trlafleur/Sensor-3/README.md

# Sensor-3-4

Sensor 3, Water Presssure, Moisture and flow sensor. Uses a Feather or RocketStream processor

Sensor 4, has an embedded M4F CPU, RFM95CW and CubeCell AM01 LoRa radio

Sensor 4a, Has an embedded M0 CPU, RFM95CW and E78-900M22S LoRa radio

See .PDF for documentation
