trlafleur/Sensor-3/WaterSensor V3-5b.xls

Sheet: Part List Report
Part List |  | Bill of Materials for PCB Document [PCB1.PcbDoc]
Source Data From: |  | PCB1.PcbDoc
Project: |  | WaterSensor V3-5b.PrjPcb
Variant: |  | None
Report Date: | 10/23/2019 | 3:49 PM
Print Date: | 2019-10-23 | 15:49:48
Designator | Comment | LibRef | Footprint | Description
C1, C10 | TBD | CAP_1 | 805 | Capacitor
C2, C21 | .1uf | CAP_1, CAP_2 | 6-0805 | Capacitor
C3, C23 | 47uf | CAP_1 | C1210 | Capacitor
C4 | Cap Pol2 | Cap Pol2 | Capacitor 12x5x18 | Polarized Capacitor (Axial)
C5, C11, C12, C13, C14, C19 | .1uf | CAP_1 | 805 | Capacitor
C6, C7, C9 | 22uf | CAP_1 | C1206 | Capacitor
C8 | 10uf/50V | CAP_1 | C1206 | Capacitor
C17 | 10uf | CAP_1 | C1206 | Capacitor
C20 | .22uf | CAP_1 | 6-0805 | Capacitor
C22 | 22uf | CAP_2 | 805 | Capacitor
C24 | .022uf | CAP_1 | 805 | Capacitor
D1 | DF01S | Bridge DF01S | SOP4-BRIDGE
D2 | Charge | LTST150 | LED 0805
D4 | Error | LTST150 | LED 0805
D5 | RX | LTST150 | LED 0805
D6 | TX | LTST150 | LED 0805
D7 | PWR 3.3V | LTST150 | LED 0805
D8, D9, D10, D11 | MMBZxV1A | MMBZ9V1A | SOT23 | Zener Transient Voltage Suppressors
D12, D15, D16 | MBR140SFT1G | Diode Schottky | SOD123FL-2 | Schottky Diode
F1 | Poly Fuse 300ma | Poly Fuse | PTC 2016L | Poly Fuse
F2 | Poly Fuse 50ma | Poly Fuse | c1206 | Poly Fuse
J1 | TS2A | TS2A | TS3.81X2 | Screw Terminal, 3.81mm (.15in) 2X
J2, J3 | TS8A | TS8A | TS3.81X8 | Screw Terminal 3.81mm (.15in) 8X
L1 | SRR5028-470Y | SRR5028-470Y | BOUR-SRR5028_V -MOD | SDR0403 Series Power Inductor, 18 uF +/- 20 %, 0.34 Ohm, -40 to 125 degC, 2-Pin SMD, RoHS, Tape and Reel
P1 | Extra | Header 6 | HDR1X6 | Header, 6-Pin
P2 | UART1-FTDI-3.3V | Header 6 | HDR1X6 | Header, 6-Pin
P3 | I2C | Header 4 | HDR1X4 | Header, 4-Pin
R1, R2, R18 | TBD | ERJ8EN | 6-0805 | Precision Thick Film Chip Resistor, 10 Ohm to 2.2M Ohm Range, 1% Tolerance, 1206 Size, 0.125 W
R3, R23, R32 | 10K | ERJ8EN | 6-0805 | Precision Thick Film Chip Resistor, 10 Ohm to 2.2M Ohm Range, 1% Tolerance, 1206 Size, 0.125 W
R4 | 560 | ERJ8EN | 6-0805 | Precision Thick Film Chip Resistor, 10 Ohm to 2.2M Ohm Range, 1% Tolerance, 1206 Size, 0.125 W
R5, R6, R7, R8 | 1k | ERJ8EN | 6-0805 | Precision Thick Film Chip Resistor, 10 Ohm to 2.2M Ohm Range, 1% Tolerance, 1206 Size, 0.125 W
R9, R10 | 4.7k | ERJ8EN | 6-0805 | Precision Thick Film Chip Resistor, 10 Ohm to 2.2M Ohm Range, 1% Tolerance, 1206 Size, 0.125 W
R11, R12 | 4.7k 1% | ERJ8EN | 6-0805 | Precision Thick Film Chip Resistor, 10 Ohm to 2.2M Ohm Range, 1% Tolerance, 1206 Size, 0.125 W
R13, R20, R21, R24, R28, R29 | 0 Ohms | ERJ8EN | 6-0805 | Precision Thick Film Chip Resistor, 10 Ohm to 2.2M Ohm Range, 1% Tolerance, 1206 Size, 0.125 W
R17 | TBD | ERJ8EN | C1206 | Precision Thick Film Chip Resistor, 10 Ohm to 2.2M Ohm Range, 1% Tolerance, 1206 Size, 0.125 W
R19, R22, R30 | NU | ERJ8EN | 6-0805 | Precision Thick Film Chip Resistor, 10 Ohm to 2.2M Ohm Range, 1% Tolerance, 1206 Size, 0.125 W
R26 | 5.76k 1% | ERJ8EN | 6-0805 | Precision Thick Film Chip Resistor, 10 Ohm to 2.2M Ohm Range, 1% Tolerance, 1206 Size, 0.125 W
R27 | 1.02k 1% | ERJ8EN | 6-0805 | Precision Thick Film Chip Resistor, 10 Ohm to 2.2M Ohm Range, 1% Tolerance, 1206 Size, 0.125 W
R31 | 56k | ERJ8EN | 6-0805 | Precision Thick Film Chip Resistor, 10 Ohm to 2.2M Ohm Range, 1% Tolerance, 1206 Size, 0.125 W
R33 | 5.1k | ERJ8EN | 6-0805 | Precision Thick Film Chip Resistor, 10 Ohm to 2.2M Ohm Range, 1% Tolerance, 1206 Size, 0.125 W
R34 | 51k | ERJ8EN | 6-0805 | Precision Thick Film Chip Resistor, 10 Ohm to 2.2M Ohm Range, 1% Tolerance, 1206 Size, 0.125 W
R37, R38 | 0 | ERJ8EN | 6-0805 | Precision Thick Film Chip Resistor, 10 Ohm to 2.2M Ohm Range, 1% Tolerance, 1206 Size, 0.125 W
U1 | LM2842-Q1 SOT23-6 | LM2842 | sot23-6 | .6A SIMPLE SWITCHER® Step-Down Voltage Regulator SOT23-6
U2 | MCP73831-x | MCP7381 | SOT-23-OT5_L | MCP73831 Li-Ion, Li-Polymer Charger
U3 | Adafruit Feather M0 LoRa | Feather M0 LoRa | Feather-DIP28-800mil - duplicate | Feather M0 LoRa
U4 | MAX6816 | MAX6816 | SOT143-4 | Max6816 Switch Debounce, CMOS
U5 | MCP9800A1T | MCP9800A1T | SOT-23-OT5_L | Temperature Sensor, I2C
U6 | 74HC4052 | 74HC4052 | SOP127P1030X265-16L | Dual 4-channel aAalog Mux
U7 | Si7021 | Si7021 | QFN3x3-6pin | Humidity & Temperature Sensor, I2C, 3x3mm
U8 | 74LVC2G14 | 74LVC2G07 | sot23-6 | Dual OC Driver
U9 | Rocketscream M0 LoRa | Rocket M0 LoRa | Rocket-DIP38-900mil | Rocket M0 LoRa
U10 | MIC2015 SOT23-6 | MIC2015-6 | SOT23-6_N | Power Switch, 500ma 6pin
U11 | BME680 | BME680 | BME680-EXT-Pad | Integrated Environmental Unit
U12 | BME280 | CMP-2000-05073-1 | BOSC-BME280-8_V | Combined Humidity and Pressure Sensor, 1.71 to 3.6 V, -40 to 85 degC, 8-Pin SMD, RoHS, Tape and Reel
U13 | FM24CL64B | FM24CL64B | MCHP-SOIC-SN8_N | 2K I2C Serial EEPROMs with EUI-64 Node Identity, 1.7 to 5.5 V, 400 KHz, Industrial Temperature, 8-Pin SOIC (SN8), Tape and Reel
U14 | 24AA025E64 | FM24CL64B | MCHP-SOIC-SN8_N | 2K I2C Serial EEPROMs with EUI-64 Node Identity, 1.7 to 5.5 V, 400 KHz, Industrial Temperature, 8-Pin SOIC (SN8), Tape and Reel
U15 | TC1262-3.3VDBTR | TC1262-3.3VDBTR | SOT-223-DB3_N | 500mA Fixed Output CMOS LDO, 3-Pin SOT-223, Extended Temperature, Tape and Reel
U16 | MCP6001T-E/OT | CMP-0187-00458-2 | SOT-23-OT5_N | 1 MHz, Low-Power Operational Amplifier, 5-Pin SOT-23, Extended Temperature, Tape and Reel
U17 | 1051-RCR123A | 1051 | 1051 | Undefined or Miscellaneous

Sheet: All Data
Designator | Comment | Footprint | #Column Name Error:' Layer | #Column Name Error:' Rotation | #Column Name Error:' Height(Mil) | #Column Name Error:' Height(mm) | #Column Name Error:' Center-X(Mil) | #Column Name Error:' Center-X(mm) | #Column Name Error:' Center-Y(Mil) | #Column Name Error:' Center-Y(mm) | #Column Name Error:' Pad-X(Mil) | #Column Name Error:' Pad-X(mm) | #Column Name Error:' Pad-Y(Mil) | #Column Name Error:' Pad-Y(mm) | #Column Name Error:' Ref-X(Mil) | #Column Name Error:' Ref-X(mm) | #Column Name Error:' Ref-Y(Mil) | #Column Name Error:' Ref-Y(mm)
C1, C10 | TBD | 805
C2, C21 | .1uf | 6-0805
C3, C23 | 47uf | C1210
C4 | Cap Pol2 | Capacitor 12x5x18
C5, C11, C12, C13, C14, C19 | .1uf | 805
C6, C7, C9 | 22uf | C1206
C8 | 10uf/50V | C1206
C17 | 10uf | C1206
C20 | .22uf | 6-0805
C22 | 22uf | 805
C24 | .022uf | 805
D1 | DF01S | SOP4-BRIDGE
D2 | Charge | LED 0805
D4 | Error | LED 0805
D5 | RX | LED 0805
D6 | TX | LED 0805
D7 | PWR 3.3V | LED 0805
D8, D9, D10, D11 | MMBZxV1A | SOT23
D12, D15, D16 | MBR140SFT1G | SOD123FL-2
F1 | Poly Fuse 300ma | PTC 2016L
F2 | Poly Fuse 50ma | c1206
J1 | TS2A | TS3.81X2
J2, J3 | TS8A | TS3.81X8
L1 | SRR5028-470Y | BOUR-SRR5028_V -MOD
P1 | Extra | HDR1X6
P2 | UART1-FTDI-3.3V | HDR1X6
P3 | I2C | HDR1X4
R1, R2, R18 | TBD | 6-0805
R3, R23, R32 | 10K | 6-0805
R4 | 560 | 6-0805
R5, R6, R7, R8 | 1k | 6-0805
R9, R10 | 4.7k | 6-0805
R11, R12 | 4.7k 1% | 6-0805
R13, R20, R21, R24, R28, R29 | 0 Ohms | 6-0805
R17 | TBD | C1206
R19, R22, R30 | NU | 6-0805
R26 | 5.76k 1% | 6-0805
R27 | 1.02k 1% | 6-0805
R31 | 56k | 6-0805
R33 | 5.1k | 6-0805
R34 | 51k | 6-0805
R37, R38 | 0 | 6-0805
U1 | LM2842-Q1 SOT23-6 | sot23-6
U2 | MCP73831-x | SOT-23-OT5_L
U3 | Adafruit Feather M0 LoRa | Feather-DIP28-800mil - duplicate
U4 | MAX6816 | SOT143-4
U5 | MCP9800A1T | SOT-23-OT5_L
U6 | 74HC4052 | SOP127P1030X265-16L
U7 | Si7021 | QFN3x3-6pin
U8 | 74LVC2G14 | sot23-6
U9 | Rocketscream M0 LoRa | Rocket-DIP38-900mil
U10 | MIC2015 SOT23-6 | SOT23-6_N
U11 | BME680 | BME680-EXT-Pad
U12 | BME280 | BOSC-BME280-8_V
U13 | FM24CL64B | MCHP-SOIC-SN8_N
U14 | 24AA025E64 | MCHP-SOIC-SN8_N
U15 | TC1262-3.3VDBTR | SOT-223-DB3_N
U16 | MCP6001T-E/OT | SOT-23-OT5_N
U17 | 1051-RCR123A | 1051

Sheet: Metric
Designator | Comment | Footprint | #Column Name Error:' Layer | #Column Name Error:' Rotation | #Column Name Error:' Center-X(mm) | #Column Name Error:' Center-Y(mm) | #Column Name Error:' Pad-X(mm) | #Column Name Error:' Pad-Y(mm) | #Column Name Error:' Ref-X(mm) | #Column Name Error:' Ref-Y(mm)
C1, C10 | TBD | 805
C2, C21 | .1uf | 6-0805
C3, C23 | 47uf | C1210
C4 | Cap Pol2 | Capacitor 12x5x18
C5, C11, C12, C13, C14, C19 | .1uf | 805
C6, C7, C9 | 22uf | C1206
C8 | 10uf/50V | C1206
C17 | 10uf | C1206
C20 | .22uf | 6-0805
C22 | 22uf | 805
C24 | .022uf | 805
D1 | DF01S | SOP4-BRIDGE
D2 | Charge | LED 0805
D4 | Error | LED 0805
D5 | RX | LED 0805
D6 | TX | LED 0805
D7 | PWR 3.3V | LED 0805
D8, D9, D10, D11 | MMBZxV1A | SOT23
D12, D15, D16 | MBR140SFT1G | SOD123FL-2
F1 | Poly Fuse 300ma | PTC 2016L
F2 | Poly Fuse 50ma | c1206
J1 | TS2A | TS3.81X2
J2, J3 | TS8A | TS3.81X8
L1 | SRR5028-470Y | BOUR-SRR5028_V -MOD
P1 | Extra | HDR1X6
P2 | UART1-FTDI-3.3V | HDR1X6
P3 | I2C | HDR1X4
R1, R2, R18 | TBD | 6-0805
R3, R23, R32 | 10K | 6-0805
R4 | 560 | 6-0805
R5, R6, R7, R8 | 1k | 6-0805
R9, R10 | 4.7k | 6-0805
R11, R12 | 4.7k 1% | 6-0805
R13, R20, R21, R24, R28, R29 | 0 Ohms | 6-0805
R17 | TBD | C1206
R19, R22, R30 | NU | 6-0805
R26 | 5.76k 1% | 6-0805
R27 | 1.02k 1% | 6-0805
R31 | 56k | 6-0805
R33 | 5.1k | 6-0805
R34 | 51k | 6-0805
R37, R38 | 0 | 6-0805
U1 | LM2842-Q1 SOT23-6 | sot23-6
U2 | MCP73831-x | SOT-23-OT5_L
U3 | Adafruit Feather M0 LoRa | Feather-DIP28-800mil - duplicate
U4 | MAX6816 | SOT143-4
U5 | MCP9800A1T | SOT-23-OT5_L
U6 | 74HC4052 | SOP127P1030X265-16L
U7 | Si7021 | QFN3x3-6pin
U8 | 74LVC2G14 | sot23-6
U9 | Rocketscream M0 LoRa | Rocket-DIP38-900mil
U10 | MIC2015 SOT23-6 | SOT23-6_N
U11 | BME680 | BME680-EXT-Pad
U12 | BME280 | BOSC-BME280-8_V
U13 | FM24CL64B | MCHP-SOIC-SN8_N
U14 | 24AA025E64 | MCHP-SOIC-SN8_N
U15 | TC1262-3.3VDBTR | SOT-223-DB3_N
U16 | MCP6001T-E/OT | SOT-23-OT5_N
U17 | 1051-RCR123A | 1051

Sheet: Imperial
Designator | Comment | Footprint | #Column Name Error:' Layer | #Column Name Error:' Rotation | #Column Name Error:' Center-X(Mil) | #Column Name Error:' Center-Y(Mil) | #Column Name Error:' Pad-X(Mil) | #Column Name Error:' Pad-Y(Mil) | #Column Name Error:' Ref-X(Mil) | #Column Name Error:' Ref-Y(Mil)
C1, C10 | TBD | 805
C2, C21 | .1uf | 6-0805
C3, C23 | 47uf | C1210
C4 | Cap Pol2 | Capacitor 12x5x18
C5, C11, C12, C13, C14, C19 | .1uf | 805
C6, C7, C9 | 22uf | C1206
C8 | 10uf/50V | C1206
C17 | 10uf | C1206
C20 | .22uf | 6-0805
C22 | 22uf | 805
C24 | .022uf | 805
D1 | DF01S | SOP4-BRIDGE
D2 | Charge | LED 0805
D4 | Error | LED 0805
D5 | RX | LED 0805
D6 | TX | LED 0805
D7 | PWR 3.3V | LED 0805
D8, D9, D10, D11 | MMBZxV1A | SOT23
D12, D15, D16 | MBR140SFT1G | SOD123FL-2
F1 | Poly Fuse 300ma | PTC 2016L
F2 | Poly Fuse 50ma | c1206
J1 | TS2A | TS3.81X2
J2, J3 | TS8A | TS3.81X8
L1 | SRR5028-470Y | BOUR-SRR5028_V -MOD
P1 | Extra | HDR1X6
P2 | UART1-FTDI-3.3V | HDR1X6
P3 | I2C | HDR1X4
R1, R2, R18 | TBD | 6-0805
R3, R23, R32 | 10K | 6-0805
R4 | 560 | 6-0805
R5, R6, R7, R8 | 1k | 6-0805
R9, R10 | 4.7k | 6-0805
R11, R12 | 4.7k 1% | 6-0805
R13, R20, R21, R24, R28, R29 | 0 Ohms | 6-0805
R17 | TBD | C1206
R19, R22, R30 | NU | 6-0805
R26 | 5.76k 1% | 6-0805
R27 | 1.02k 1% | 6-0805
R31 | 56k | 6-0805
R33 | 5.1k | 6-0805
R34 | 51k | 6-0805
R37, R38 | 0 | 6-0805
U1 | LM2842-Q1 SOT23-6 | sot23-6
U2 | MCP73831-x | SOT-23-OT5_L
U3 | Adafruit Feather M0 LoRa | Feather-DIP28-800mil - duplicate
U4 | MAX6816 | SOT143-4
U5 | MCP9800A1T | SOT-23-OT5_L
U6 | 74HC4052 | SOP127P1030X265-16L
U7 | Si7021 | QFN3x3-6pin
U8 | 74LVC2G14 | sot23-6
U9 | Rocketscream M0 LoRa | Rocket-DIP38-900mil
U10 | MIC2015 SOT23-6 | SOT23-6_N
U11 | BME680 | BME680-EXT-Pad
U12 | BME280 | BOSC-BME280-8_V
U13 | FM24CL64B | MCHP-SOIC-SN8_N
U14 | 24AA025E64 | MCHP-SOIC-SN8_N
U15 | TC1262-3.3VDBTR | SOT-223-DB3_N
U16 | MCP6001T-E/OT | SOT-23-OT5_N
U17 | 1051-RCR123A | 1051

Sheet: Project Information
Project Full Path | C:\Users\lafleur\Desktop\Altium Projects\WaterSensor3 Rev5b LoRa - Feather\WaterSensor V3-5b.PrjPcb
Project Filename | WaterSensor V3-5b.PrjPcb
Variant Name | None
Data-Source Filename | PCB1.PcbDoc
Data-Source Full Path | C:\Users\lafleur\Desktop\Altium Projects\WaterSensor3 Rev5b LoRa - Feather\PCB1.PcbDoc
Title | Bill of Materials for PCB Document [PCB1.PcbDoc]
Total Quantity | 92
Report Time | 3:49 PM
Report Date | 10/23/2019
Report Date & Tine | 10/23/2019 3:49 PM
Output Name | Bill of Materials
Output Type | BOM_PartType
Output Generator Name | BOM
Output Generator Description | Bill of Materials
