trlafleur/Sensor-3/WaterSensor V3-5c.pdf

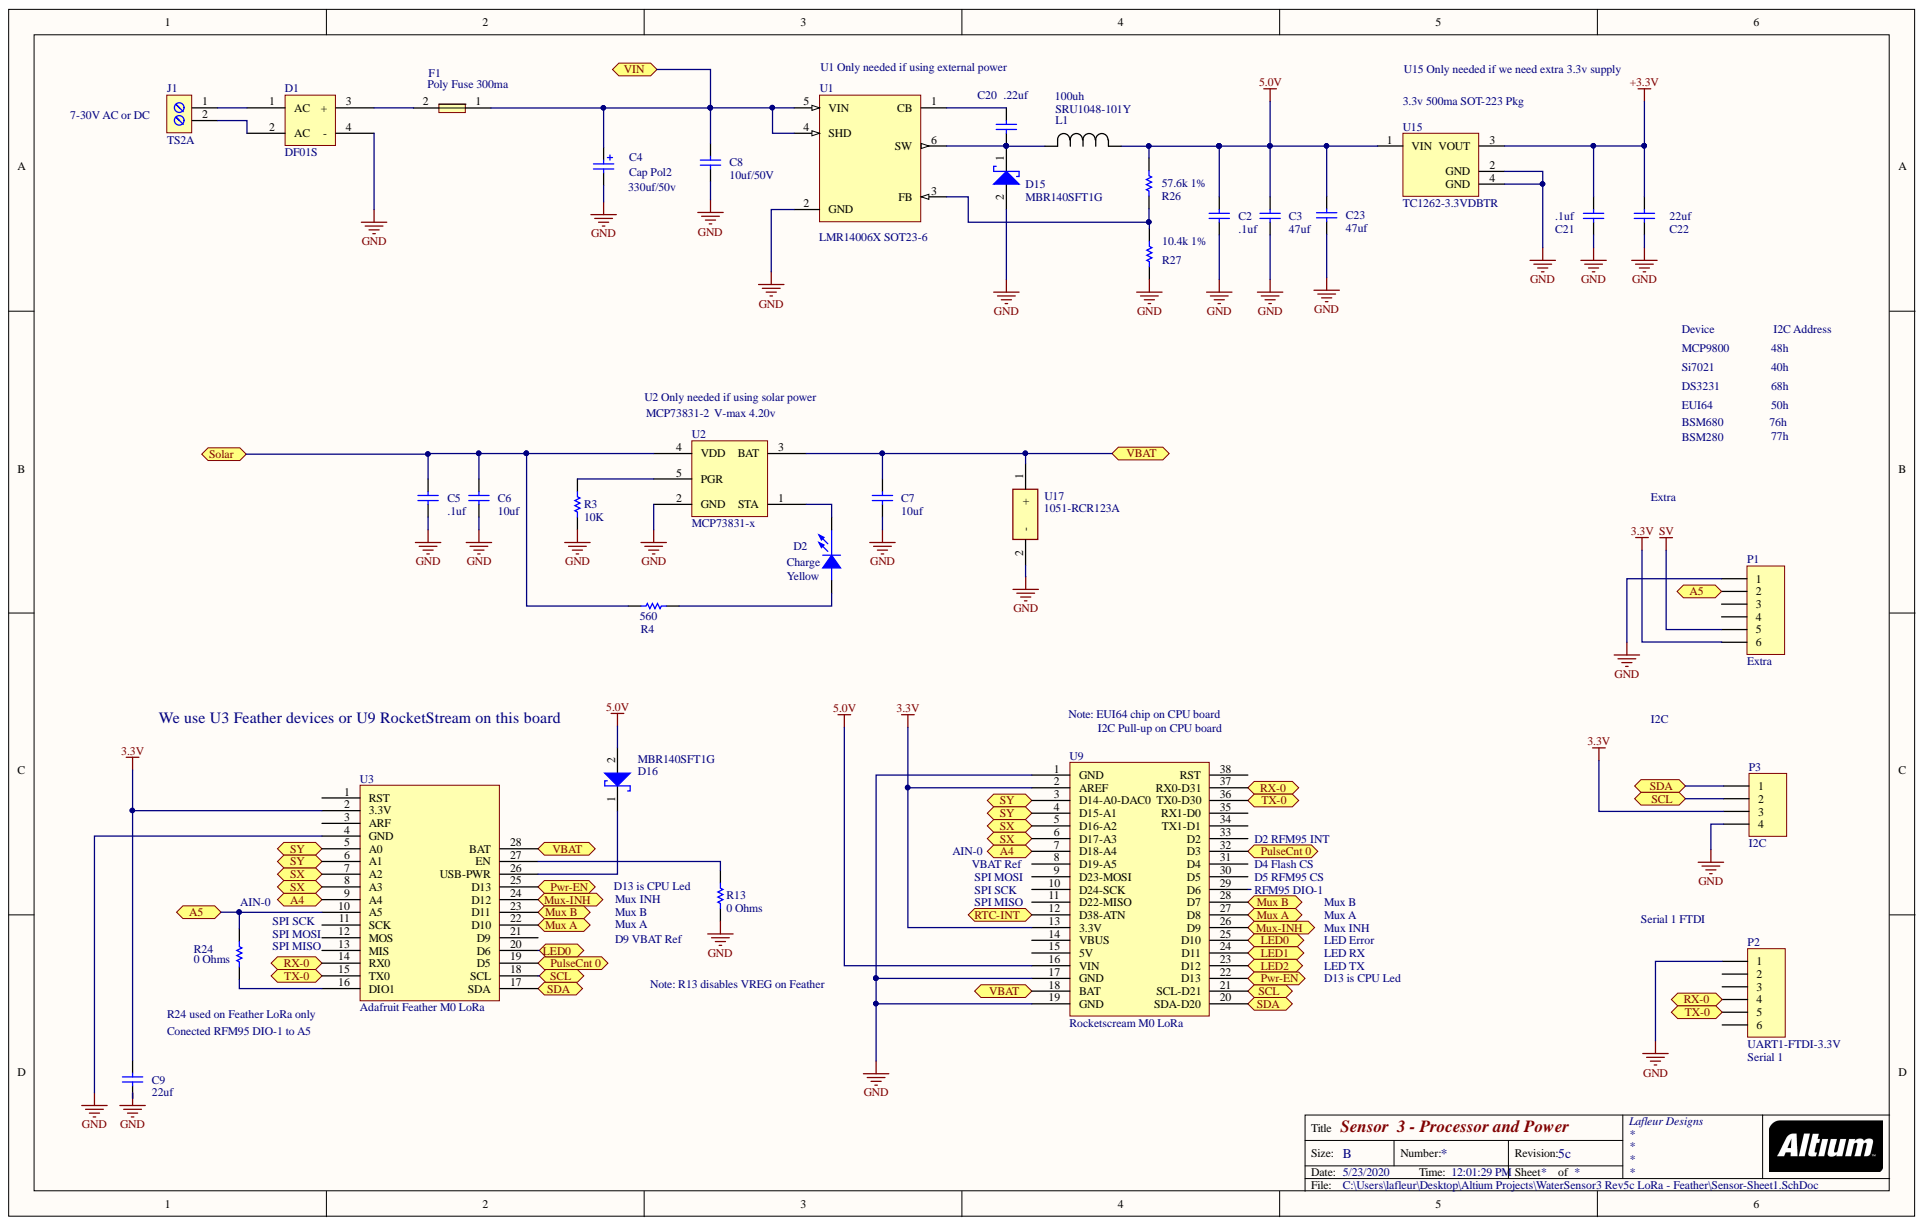
[picture p1: page 1]

U1 Only needed if using external power

U2 Only needed if using solar power
MCP73831-2 V-max 4.20v

I2C Pull-up on CPU board We use U3 Feather devices or U9 RocketStream on this board

Note: EUI64 chip on CPU board

Note: R13 disables VREG on Feather

R24 used on Feather LoRa only
Conected RFM95 DIO-1 to A5

Sensor 3 - Processor and Power
Title

C:\Users\lafleur\Desktop\Altium Projects\WaterSensor3 Rev5c LoRa - Feather\Sensor-Sheet1.SchDoc

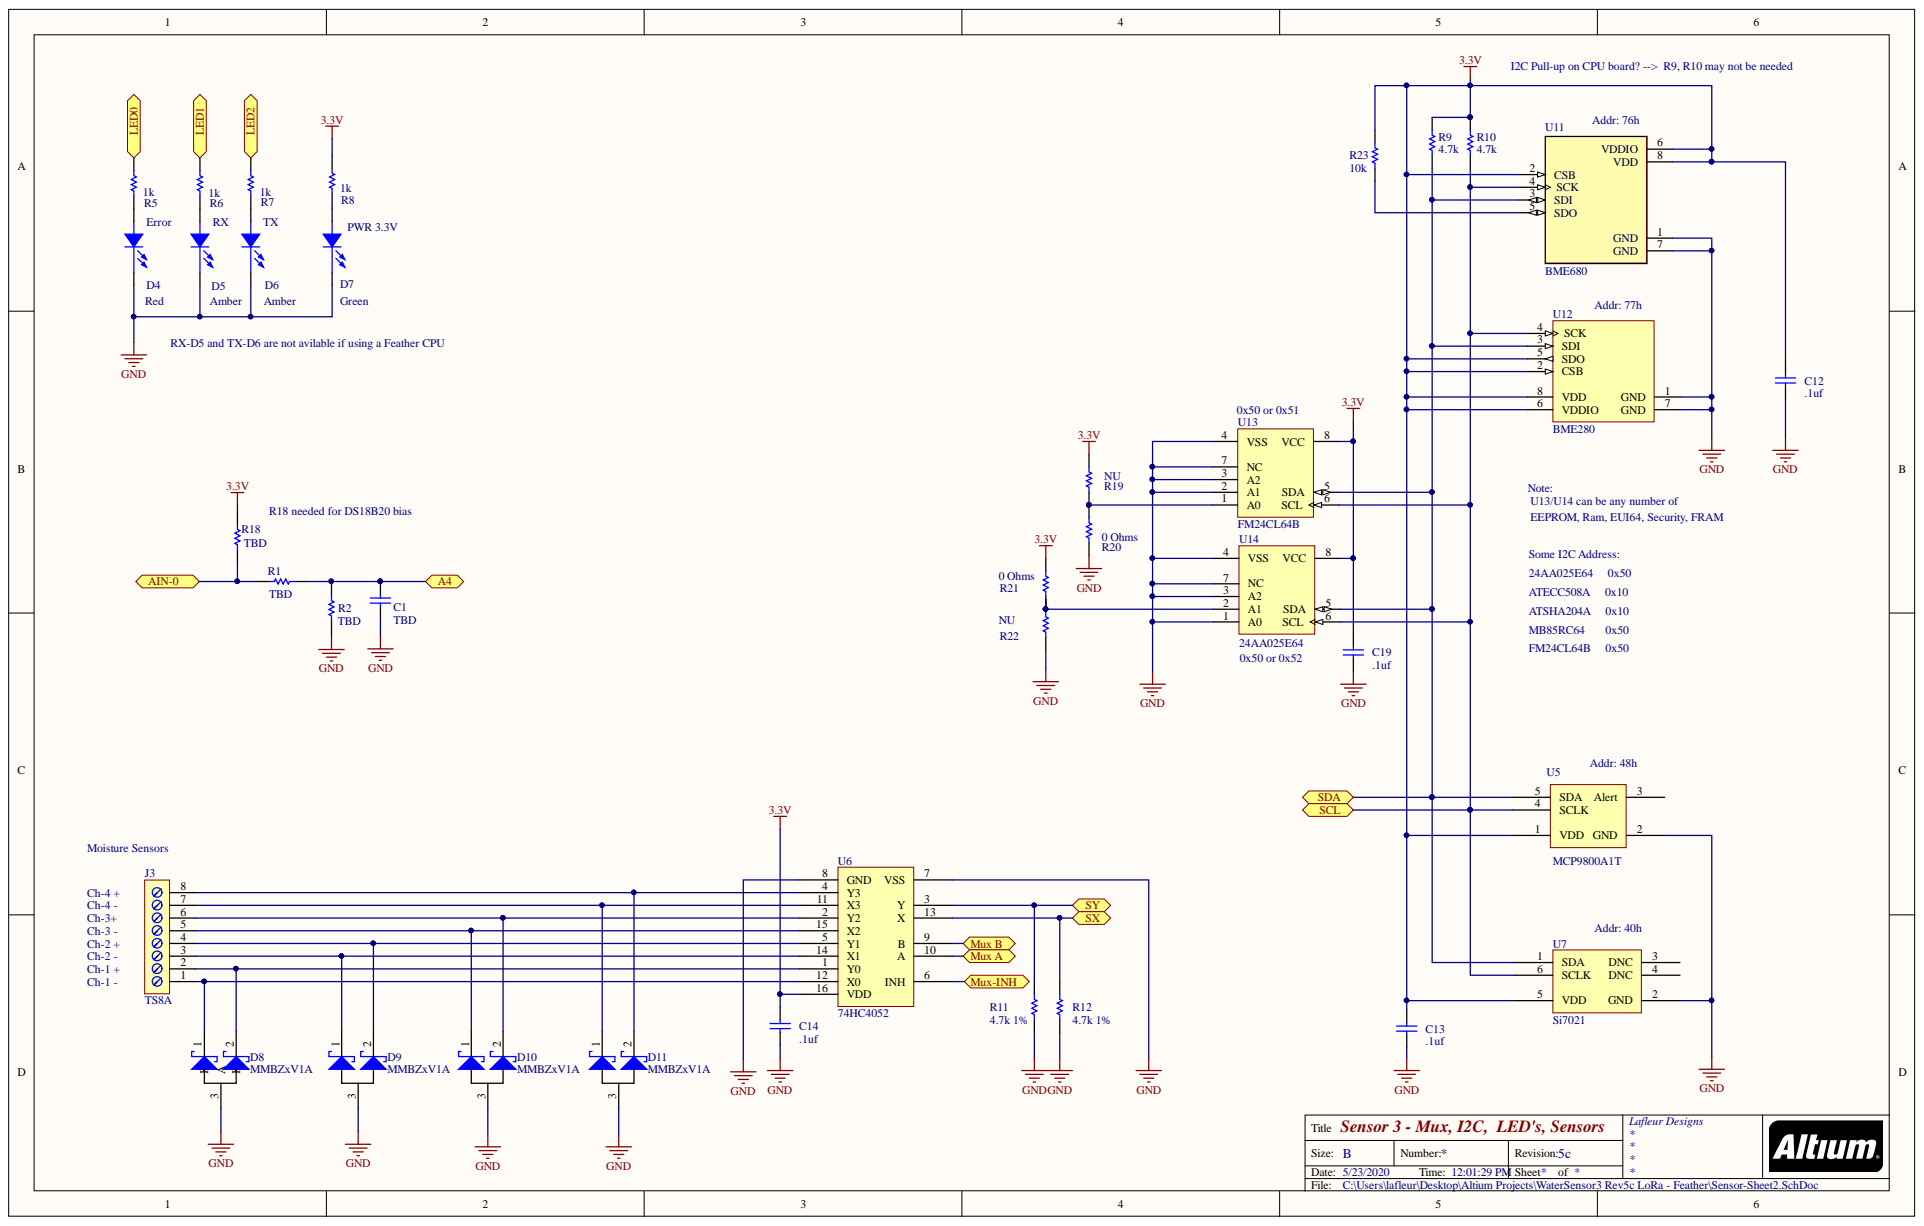
[picture p2: page 2]

55 | | G 24A AT E ATSH M FM24C

-up on CPU board? -

> R9, R10 may not be needed

2 | V D D CSB SC K SD I SD O G N D G N D | 1

Note: U13/U14 can be any number of EEPROM, Ram, EUI64, Security, FR

0 Ohm s

Ch-1 - Ch-1 + Ch-2 - Ch-2 + Ch-3 - Ch-3+ Ch-4 - Ch-4 + Moisture Sensor

1 1

Mux B Mux A Mux-IN

Date: Ti me: | Sheet * of *
Fi le: s \WaterSensor3 Rev5c LoRa - Feather \Sensor -Sheet2.SchDoc

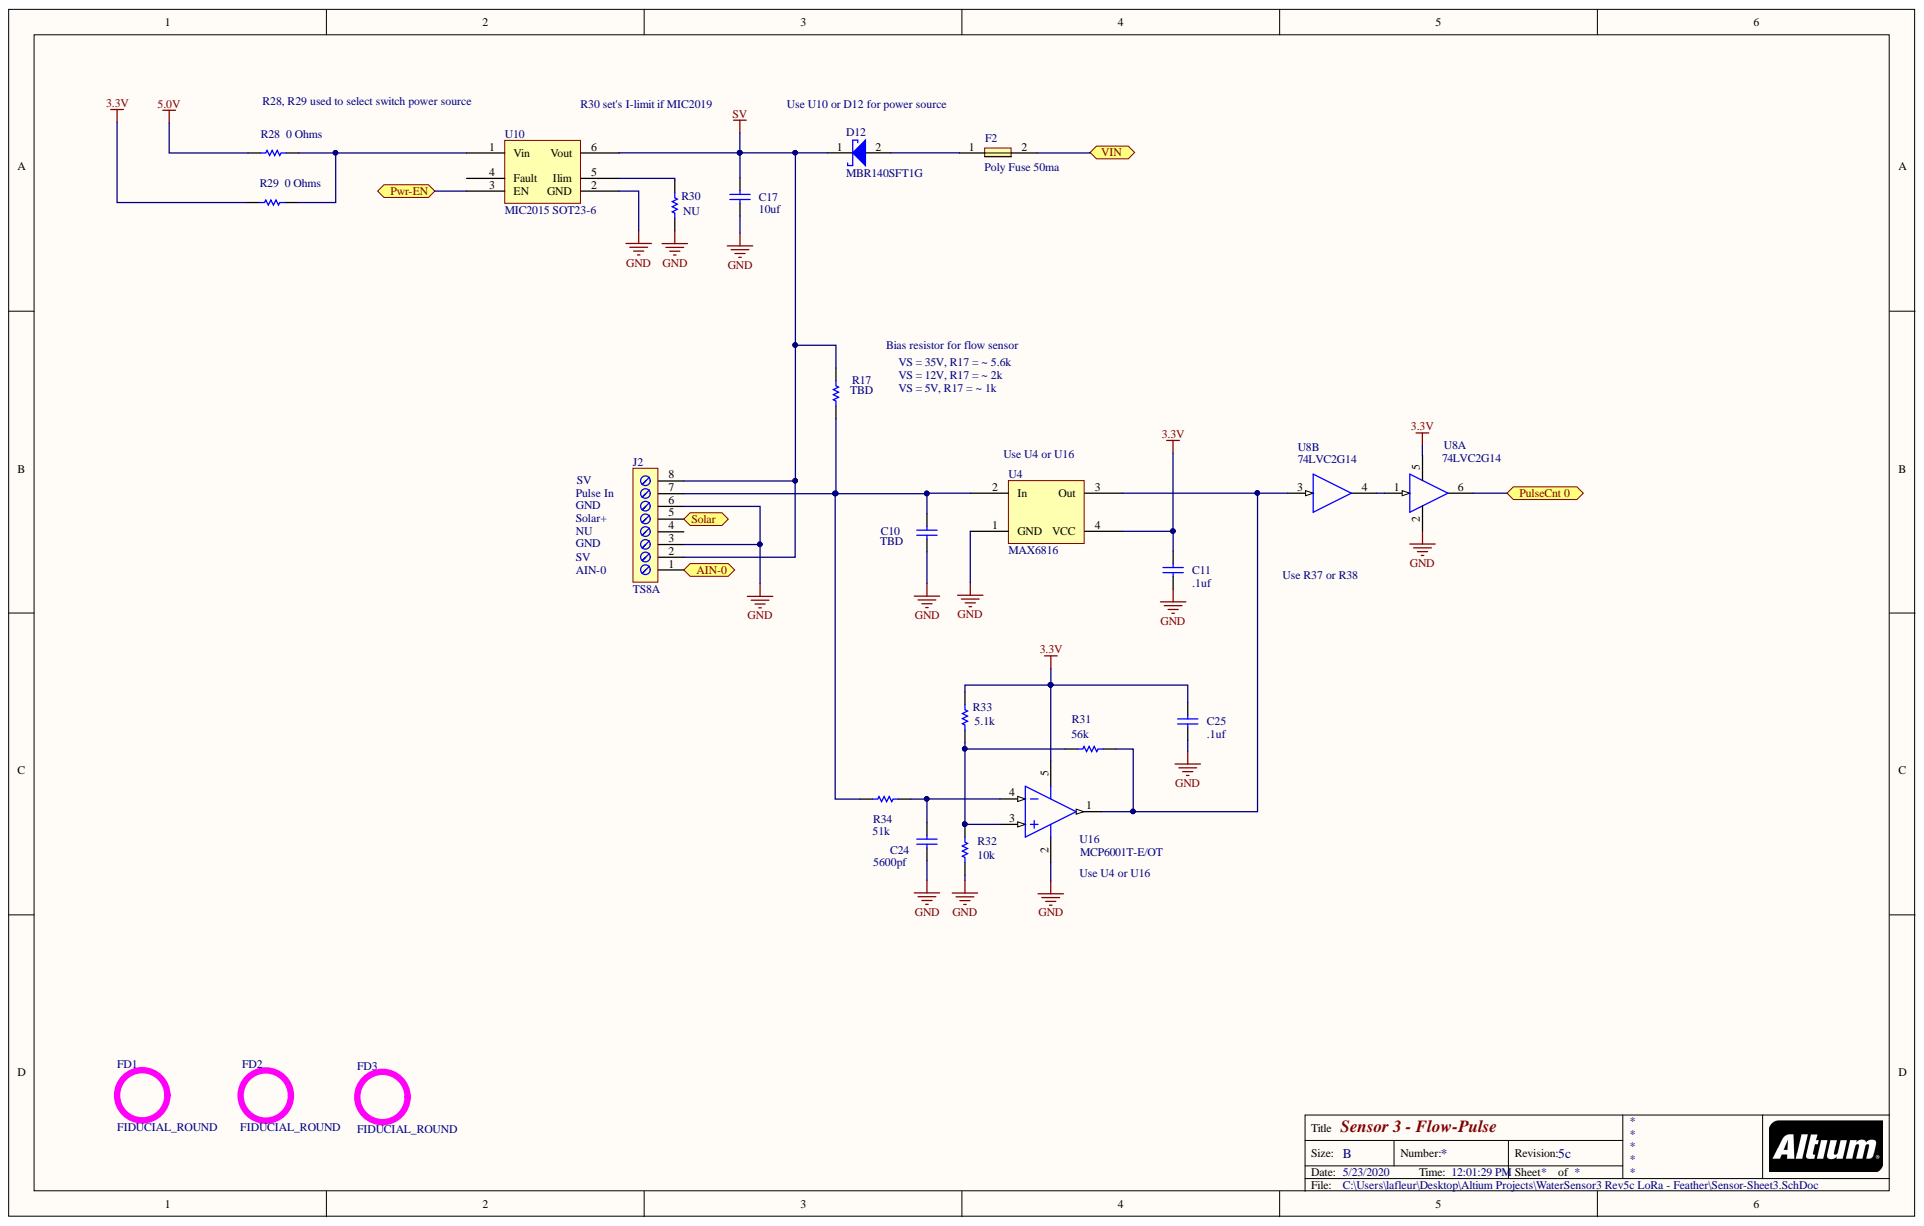
[picture p3: page 3]

Use U10 or D12 for power source

Bias resistor for flow sensor

6 | | GND 1
5 | Solar

Sensor 3 - Flow-Pulse Title | * * * * *

Size: B | Number: * | Revision: 5c
Date: 5/23/2020 Time: 12:01:29 PM | | Sheet * of *
File: C:\Users\lafleur\Desktop\Altium Projects\WaterSensor3 Rev5c LoRa - Feather\Sensor-Sheet3.SchDoc

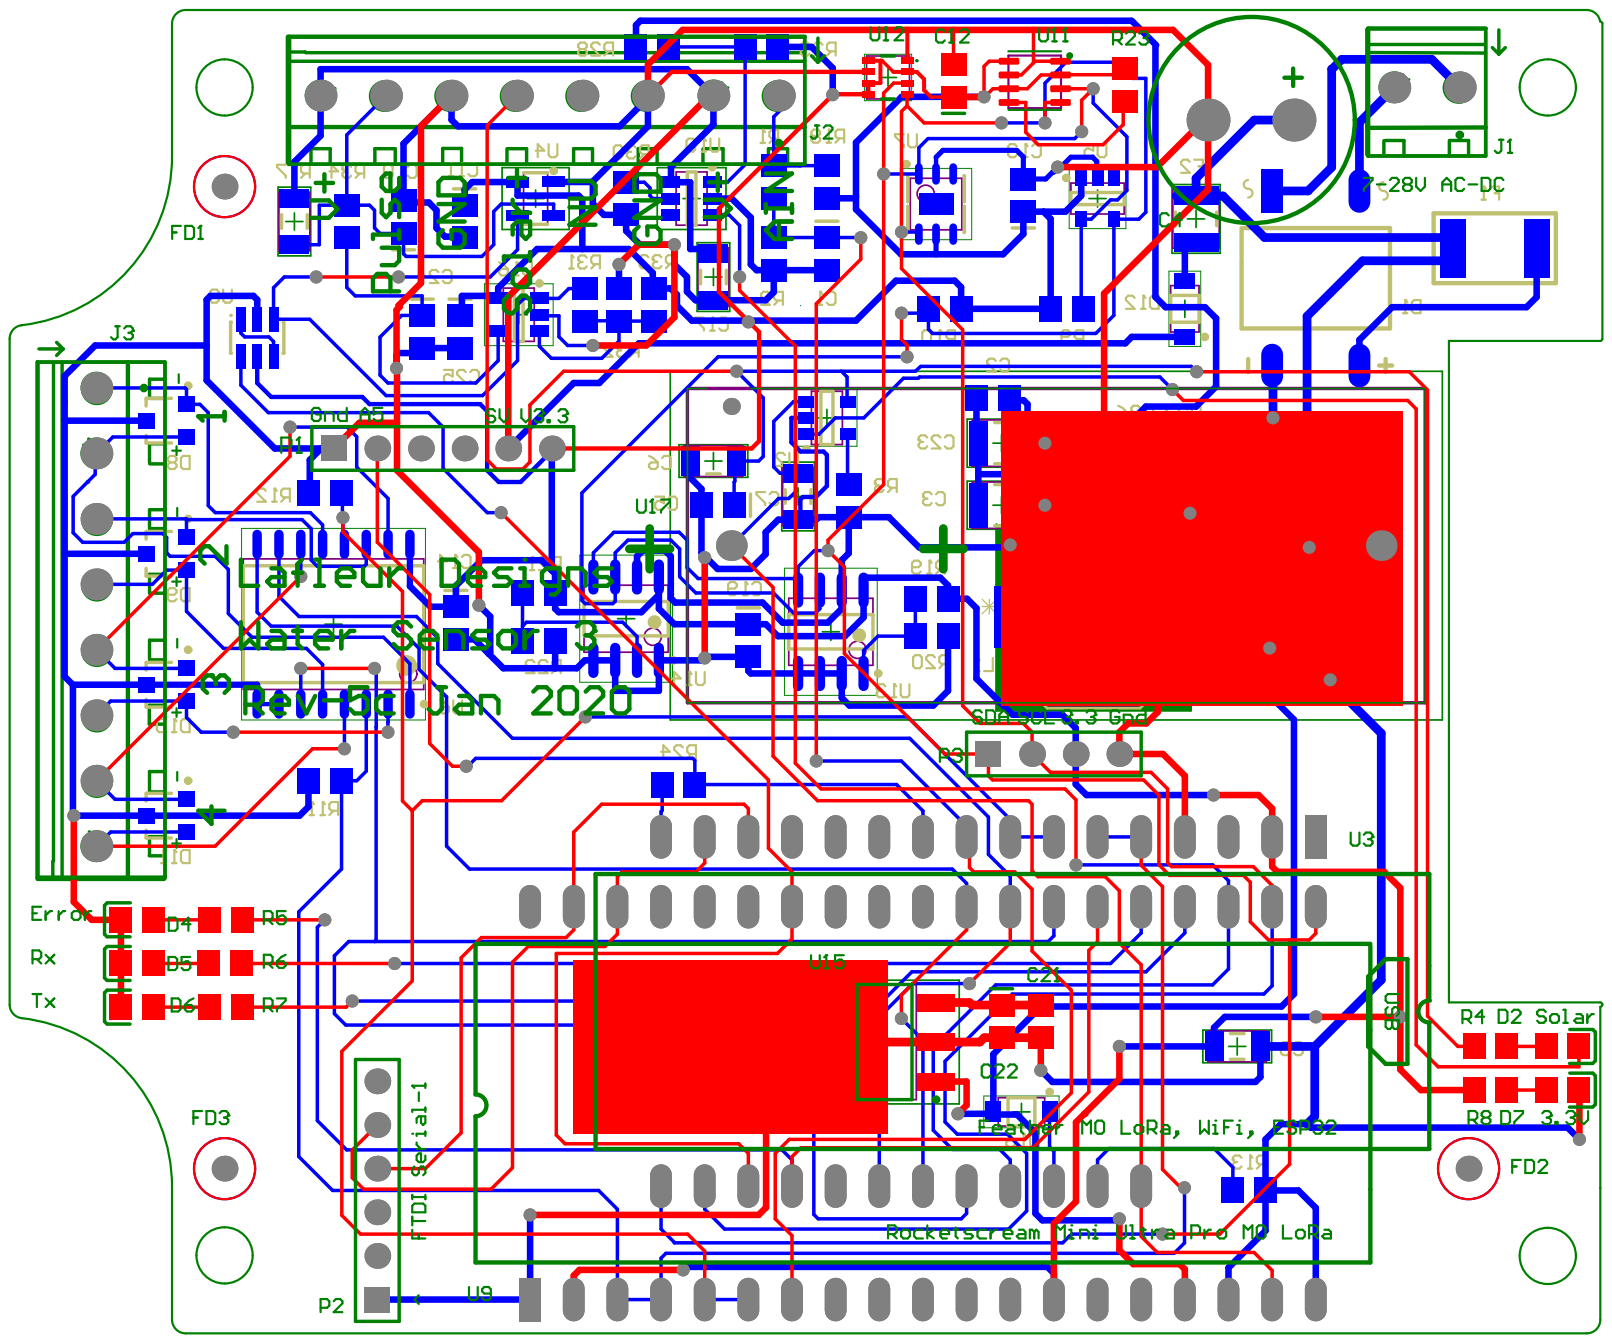
[picture p4: page 4]
