trlafleur/Sensor-3/WaterSensor V4-6a.pdf

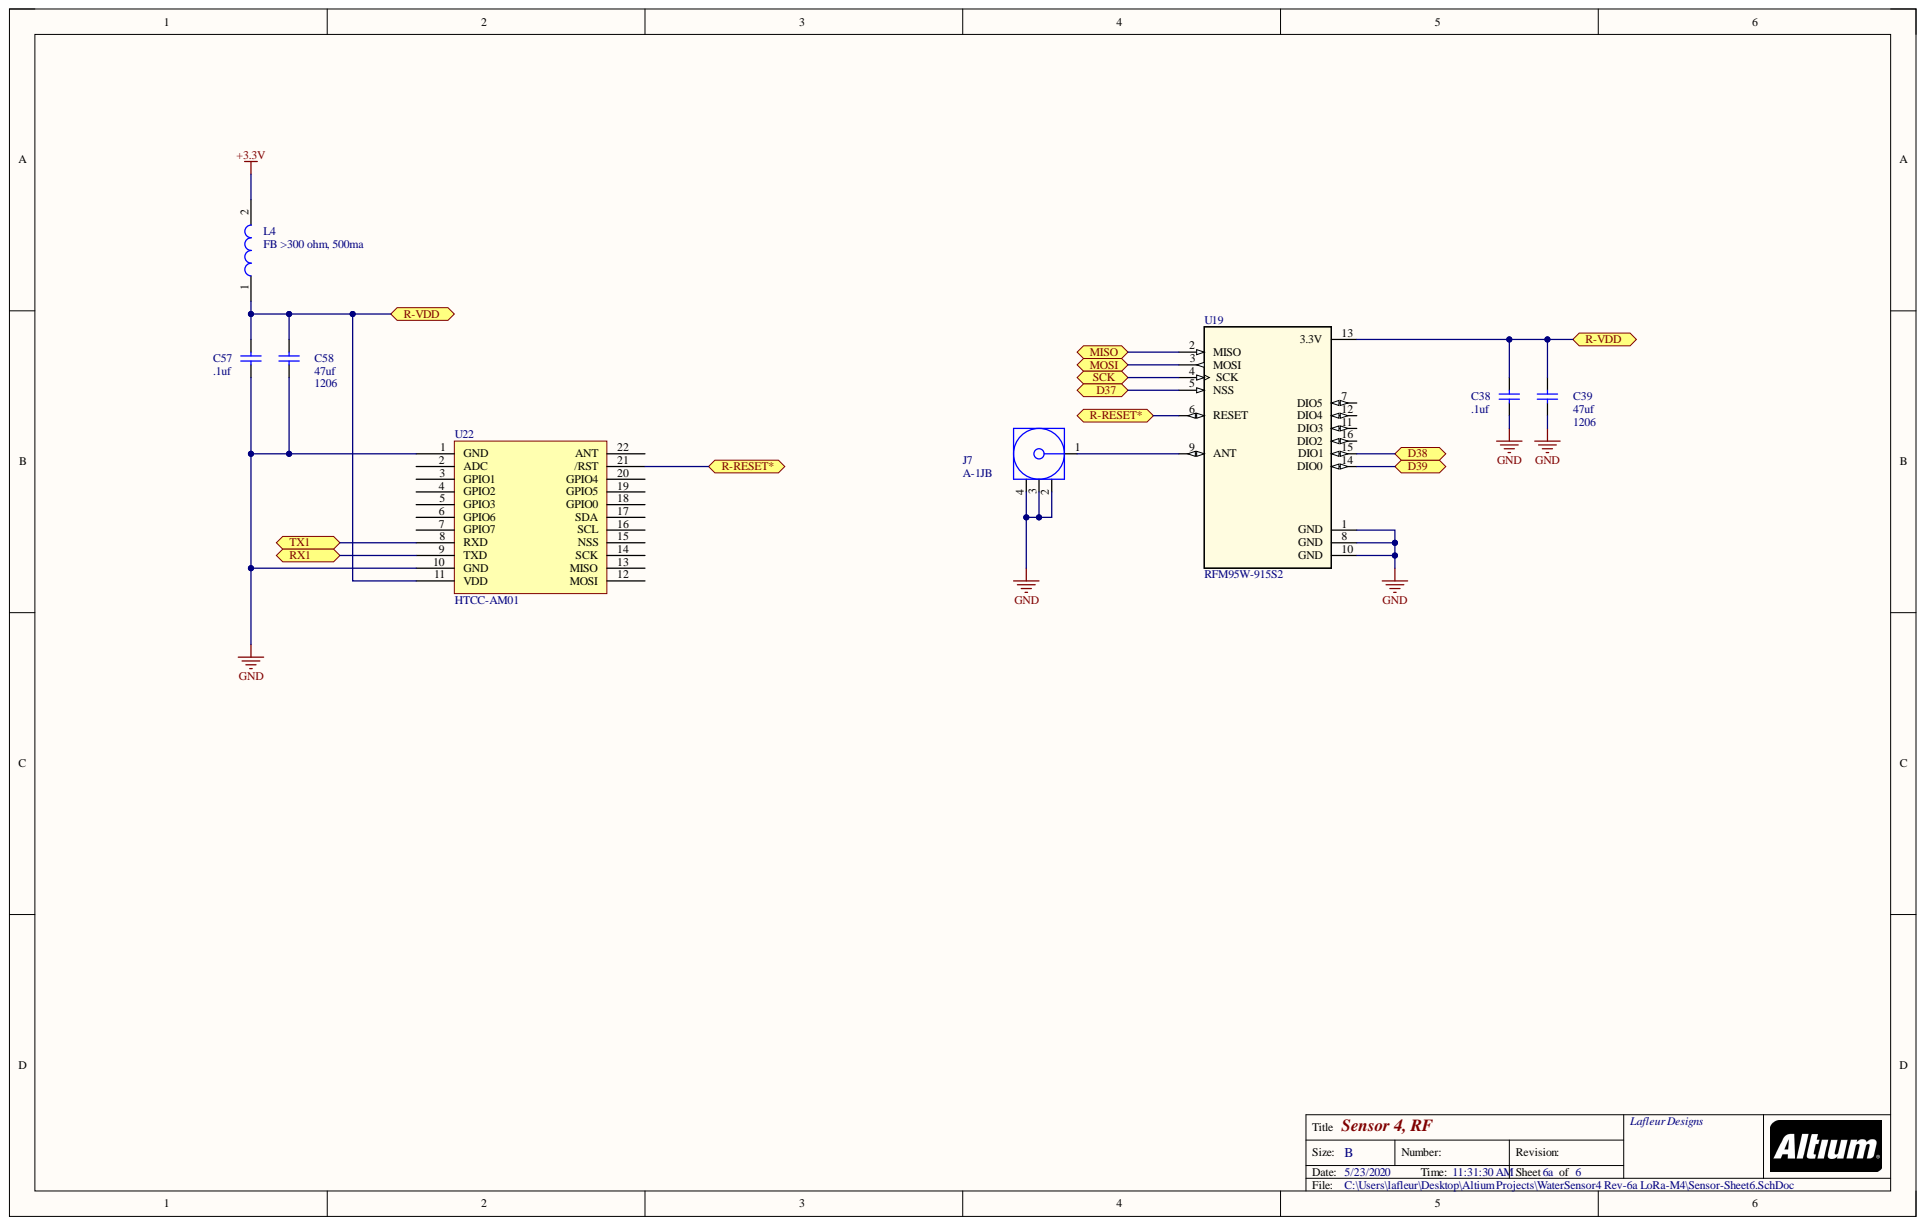
[picture p5: page 1]

Ti tl e Sensor 4, R F | Lafleur Des igns

Si z e : B | N umber : | Revi s i on:
Dat e : 5/23/ 20 20 Ti me: 11:31:30 AM | | Sheet 6 a of 6

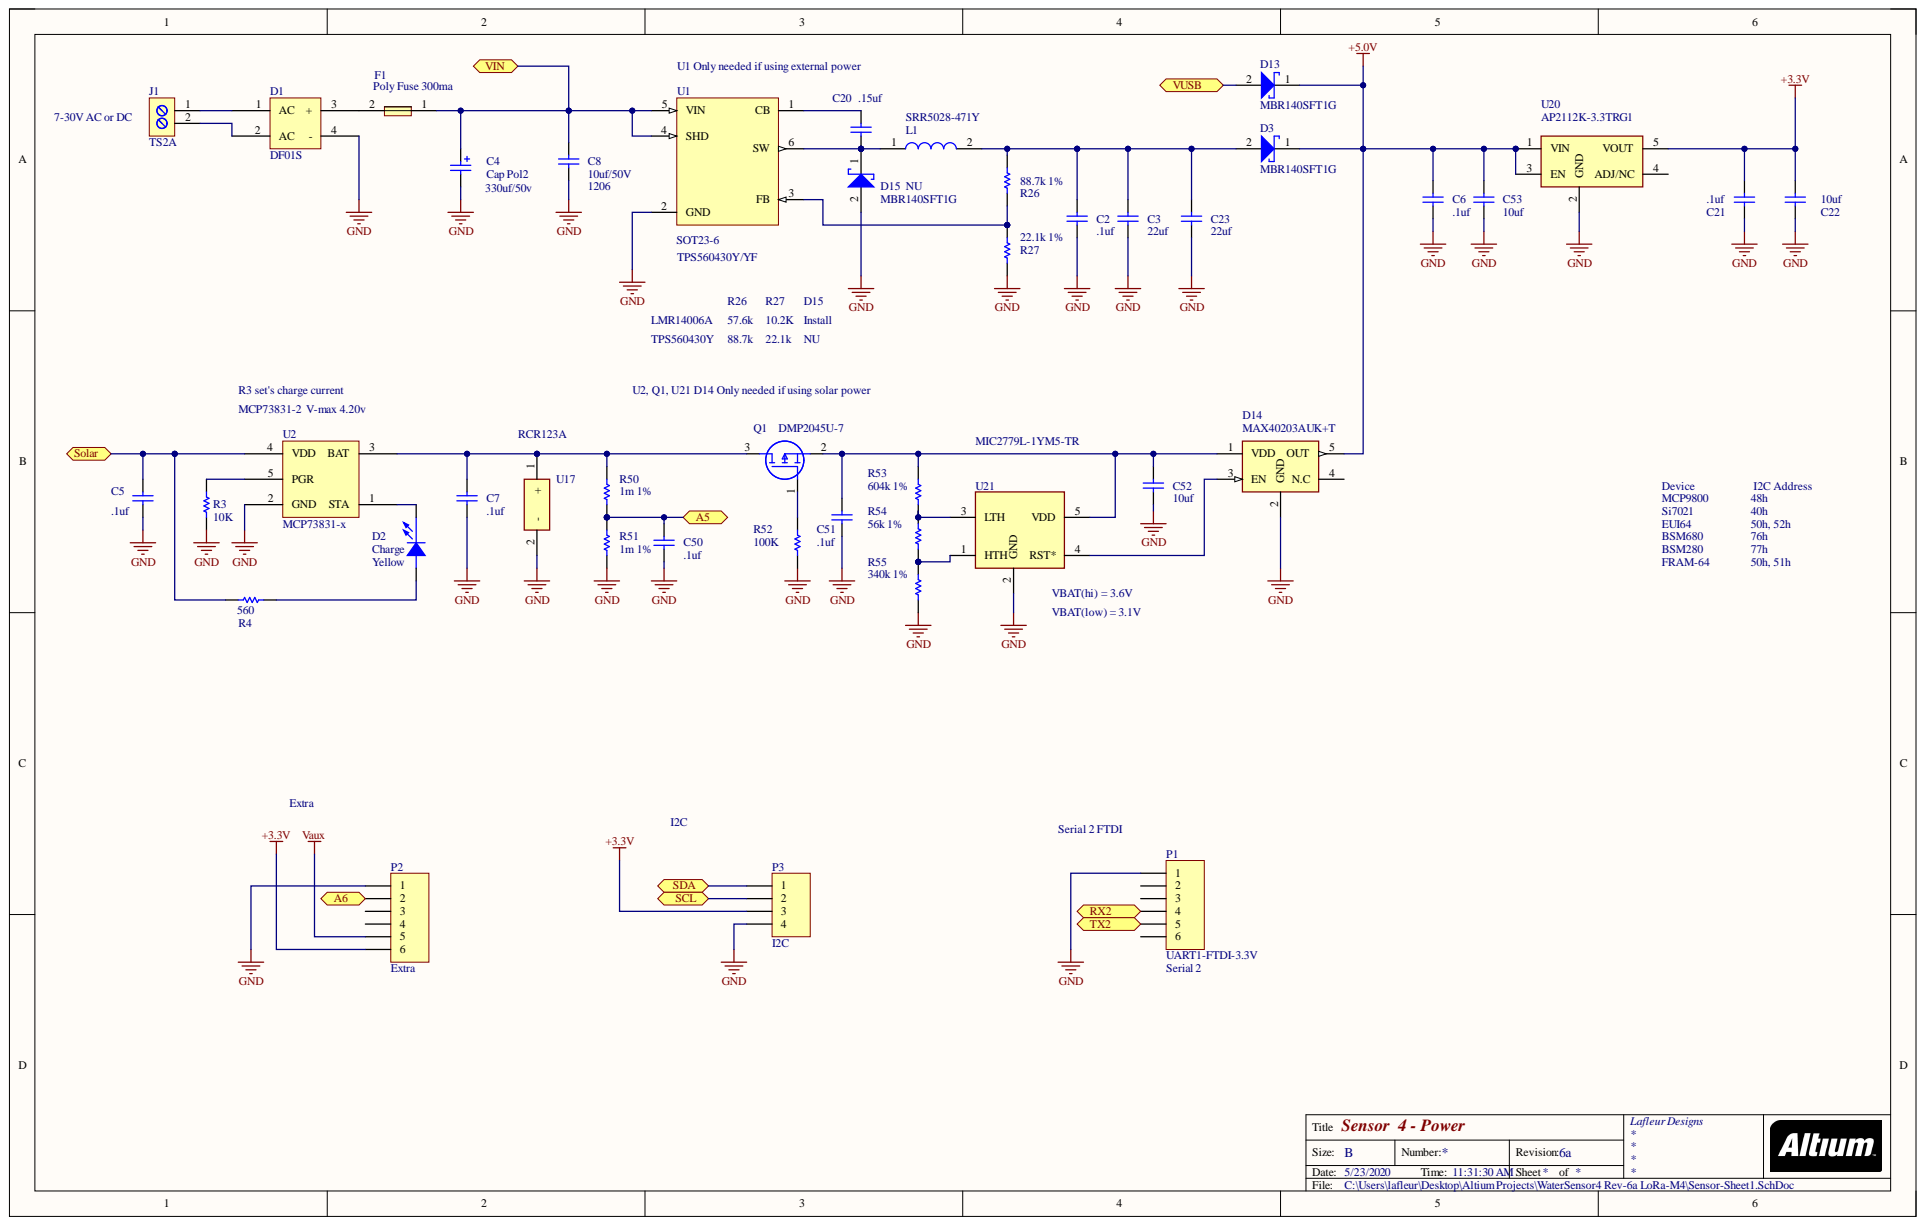
[picture p6: page 2]

U1 Only needed if using external power

U2, Q1, U21 D14 Only needed if using solar power

Title Sensor 4 - Power | Lafleur Designs * * * *

Size: B | Number: * | Revision: 6a
Date: 5/23/2020 Time: 11:31:30 AM | | Sheet * of *

C:\Users\lafleur\Desktop\AltiumProjects\WaterSensor4 Rev-6a LoRa-M4\Sensor-Sheet1.SchDoc

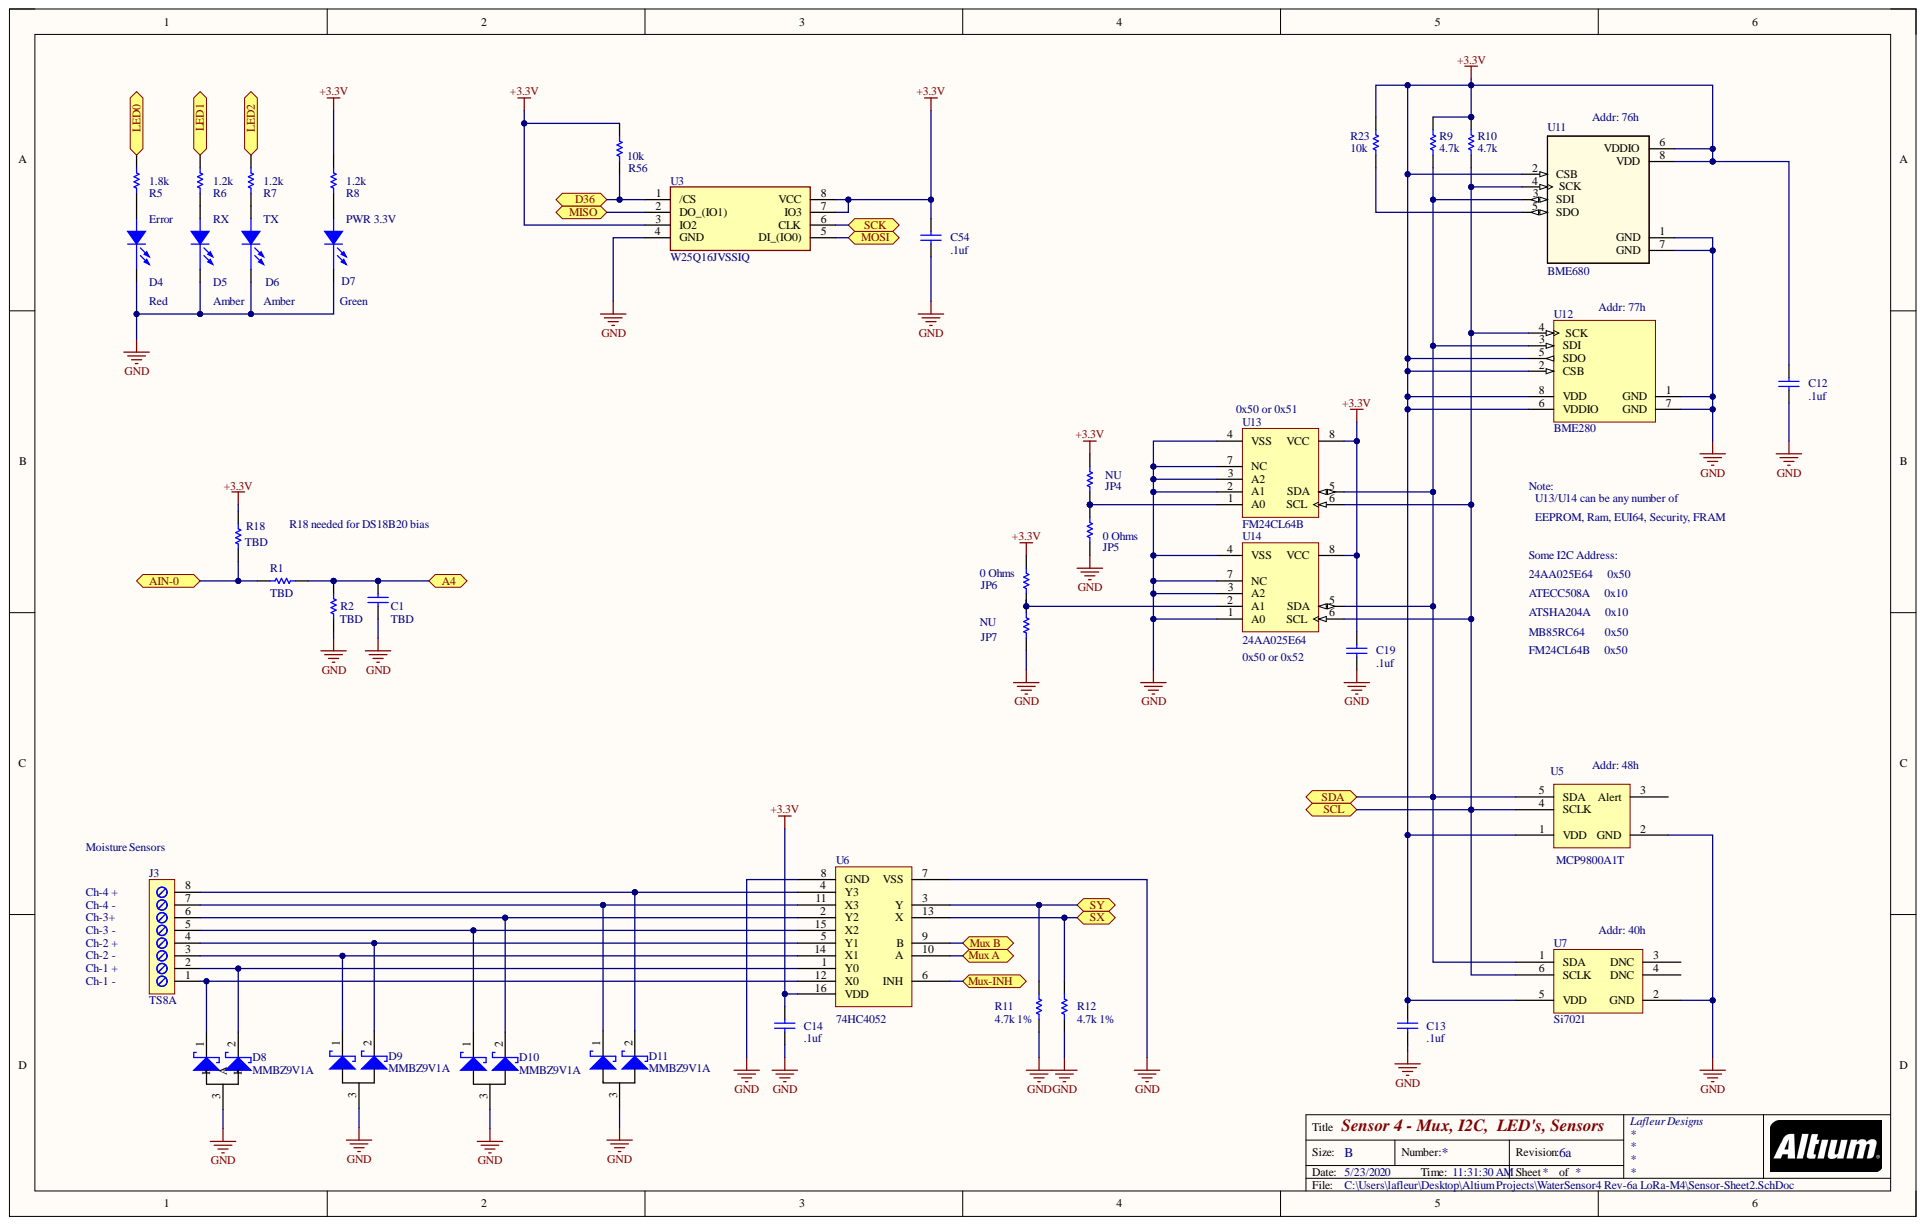
[picture p7: page 3]

+3.3V | SDI 3 SCK 4

SDO 5
CSB 2

Note:

U13/U14 can be any number of
EEPROM, Ram, EUI64, Security, FRAM

SCLK 4

Title Sensor 4 - Mux, I2C, LED's, Sensors | Lafleur Designs * * * *

Size: B | Number: * | Revision: 6a
Date: 5/23/2020 Time: 11:31:30 AM | | Sheet * of *

C:\Users\lafleur\Desktop\AltiumProjects\WaterSensor4 Rev-6a LoRa-M4\Sensor-Sheet2.SchDoc

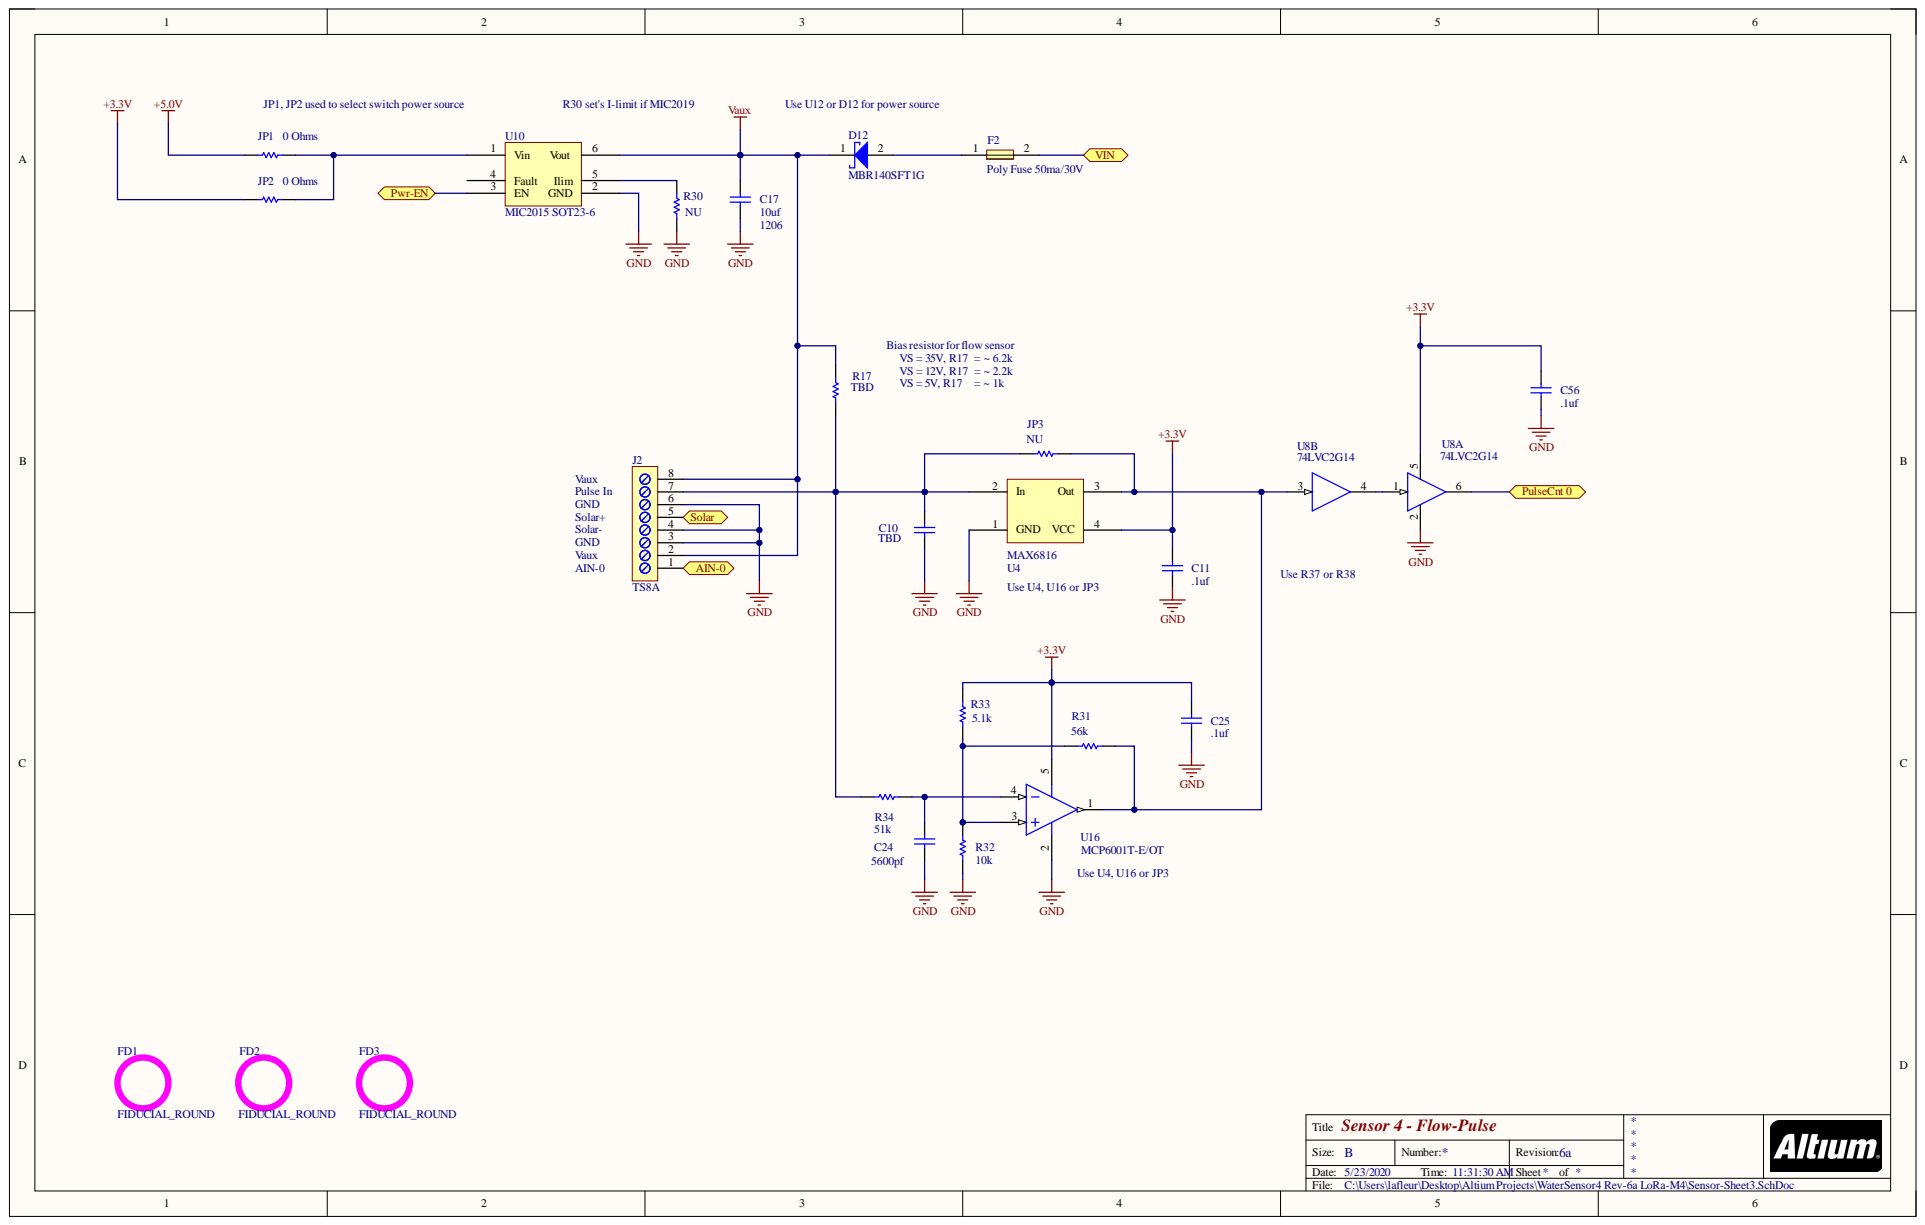
[picture p8: page 4]

Use U12 or D12 for power source

6 | | GND 1 | C11 C25
5 | Solar

Title Sensor 4 - Flow-Pulse | * * * * *

Size: B | Number: * | Revision: 6a
Date: 5/23/2020 Time: 11:31:30 AM | | Sheet * of *

C:\Users\lafleur\Desktop\AltiumProjects\WaterSensor4 Rev-6a LoRa-M4\Sensor-Sheet3.SchDoc

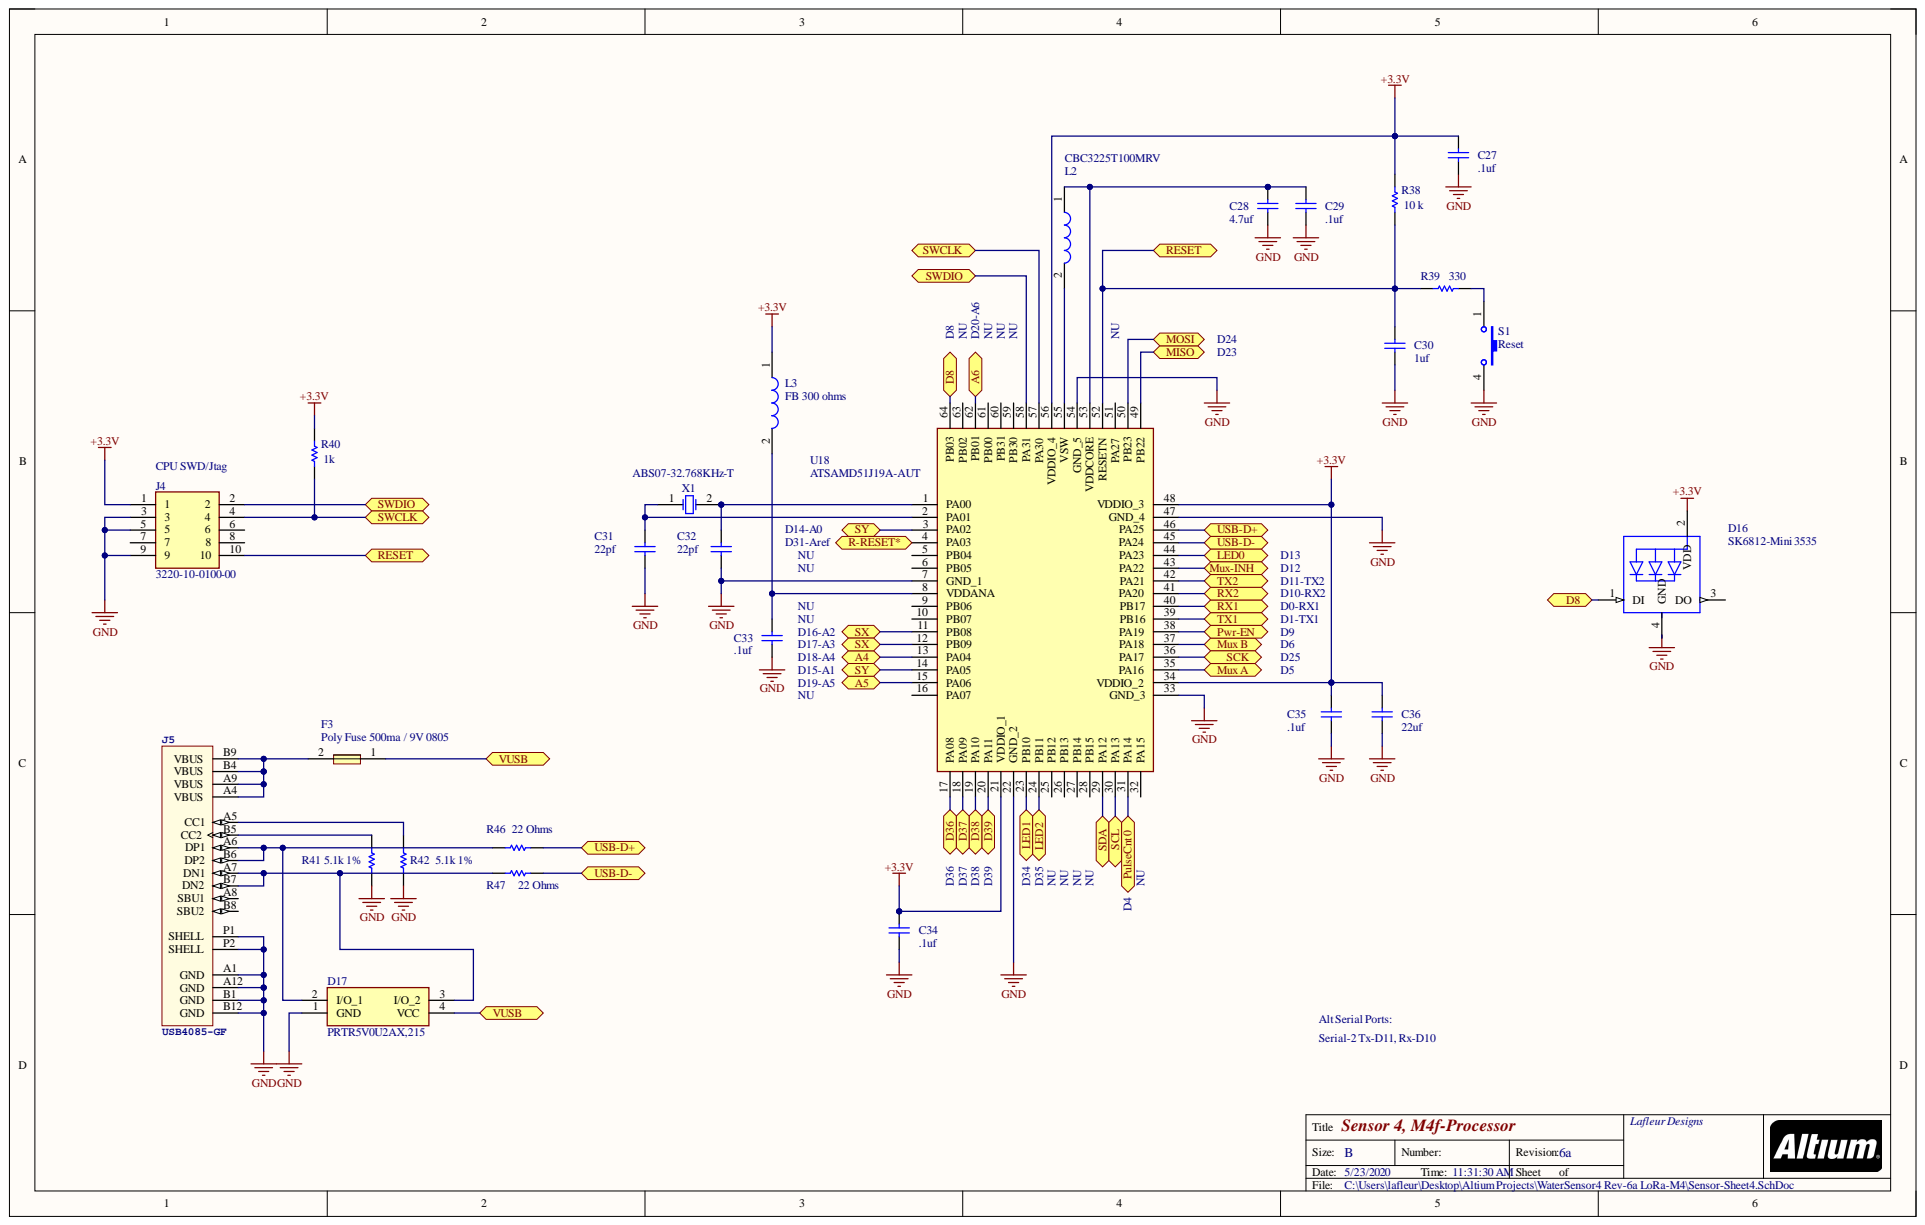
[picture p9: page 5]

A 9
A 4

Ti tl e | Lafleur Des

Si z e : B | N umber : | Revi s i on:
Dat e : 5/23/ 20 20 Ti me: 11:31:30 AM | | Sheet of

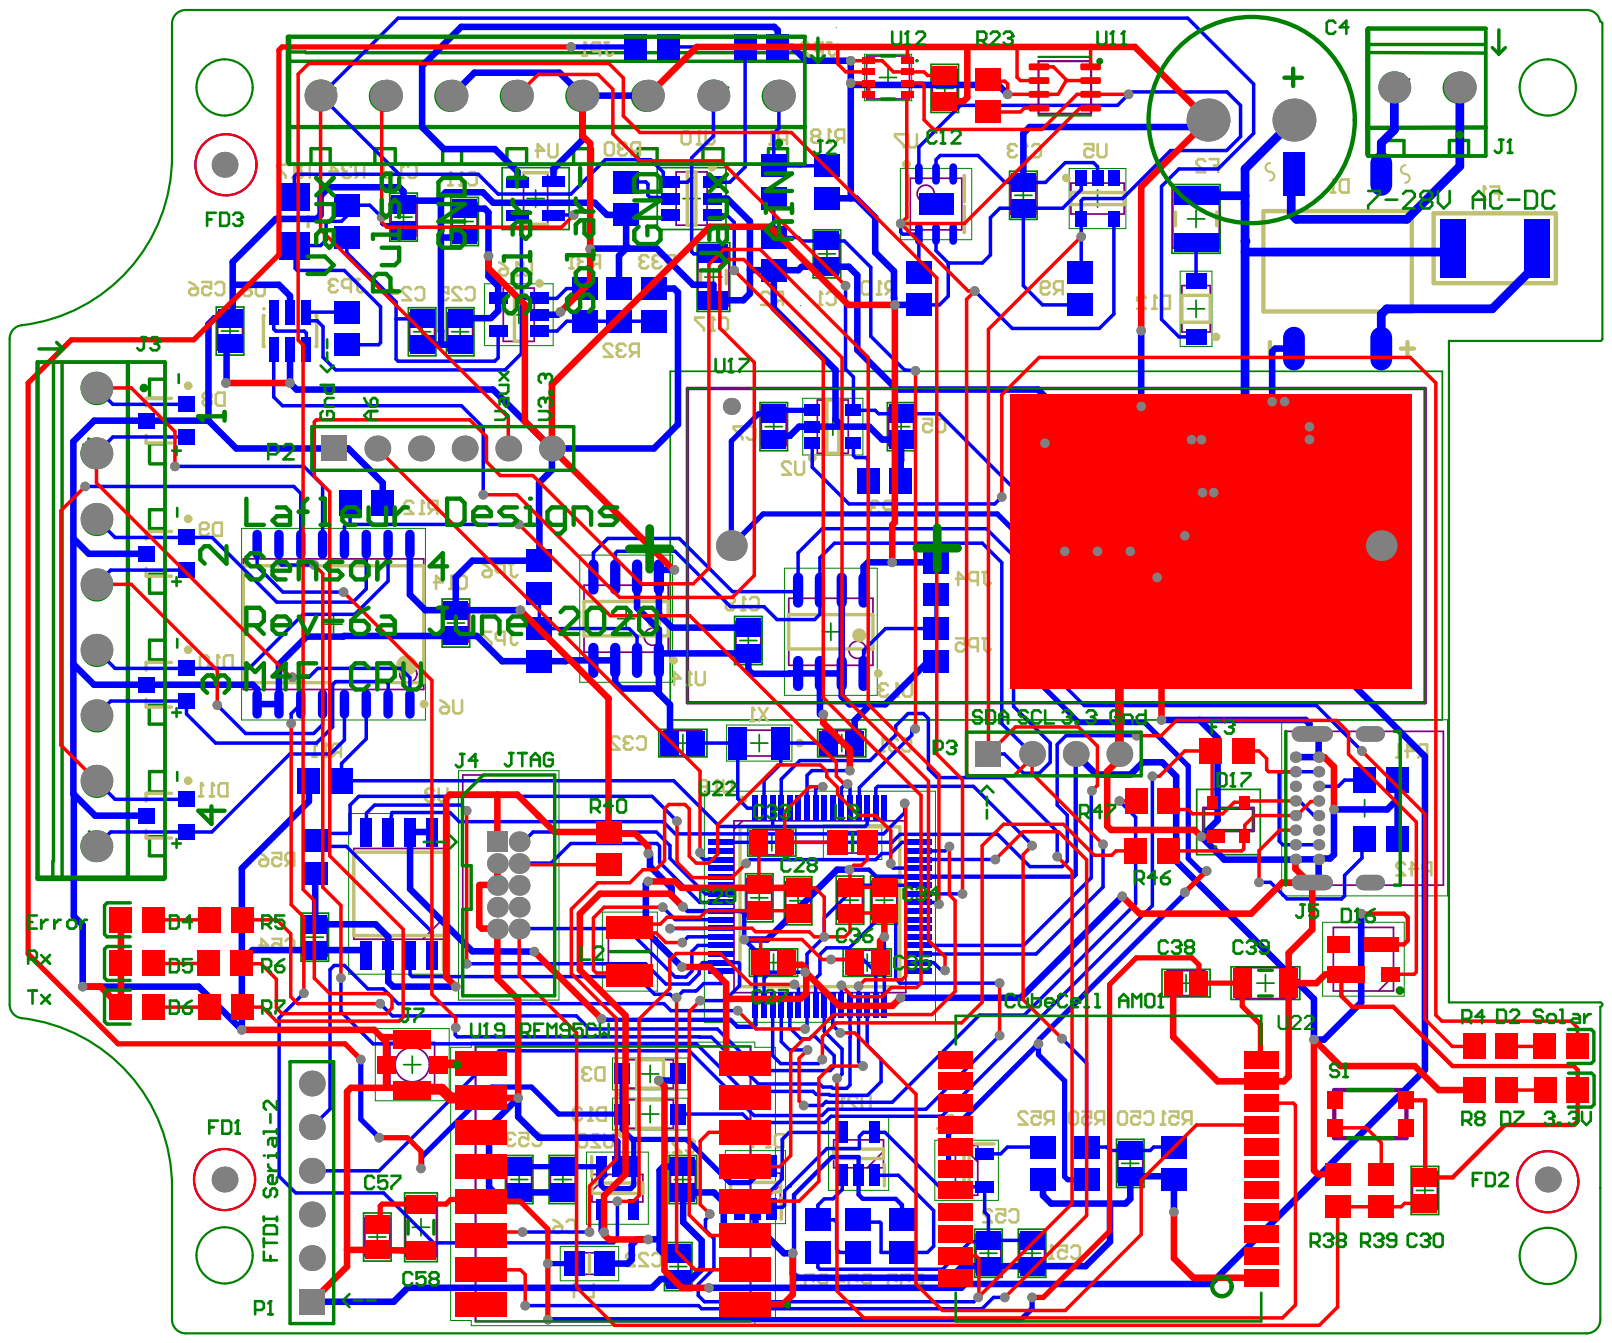
[picture p10: page 6]
