trlafleur/Sensor-3/WaterSensor V4a-6a.pdf

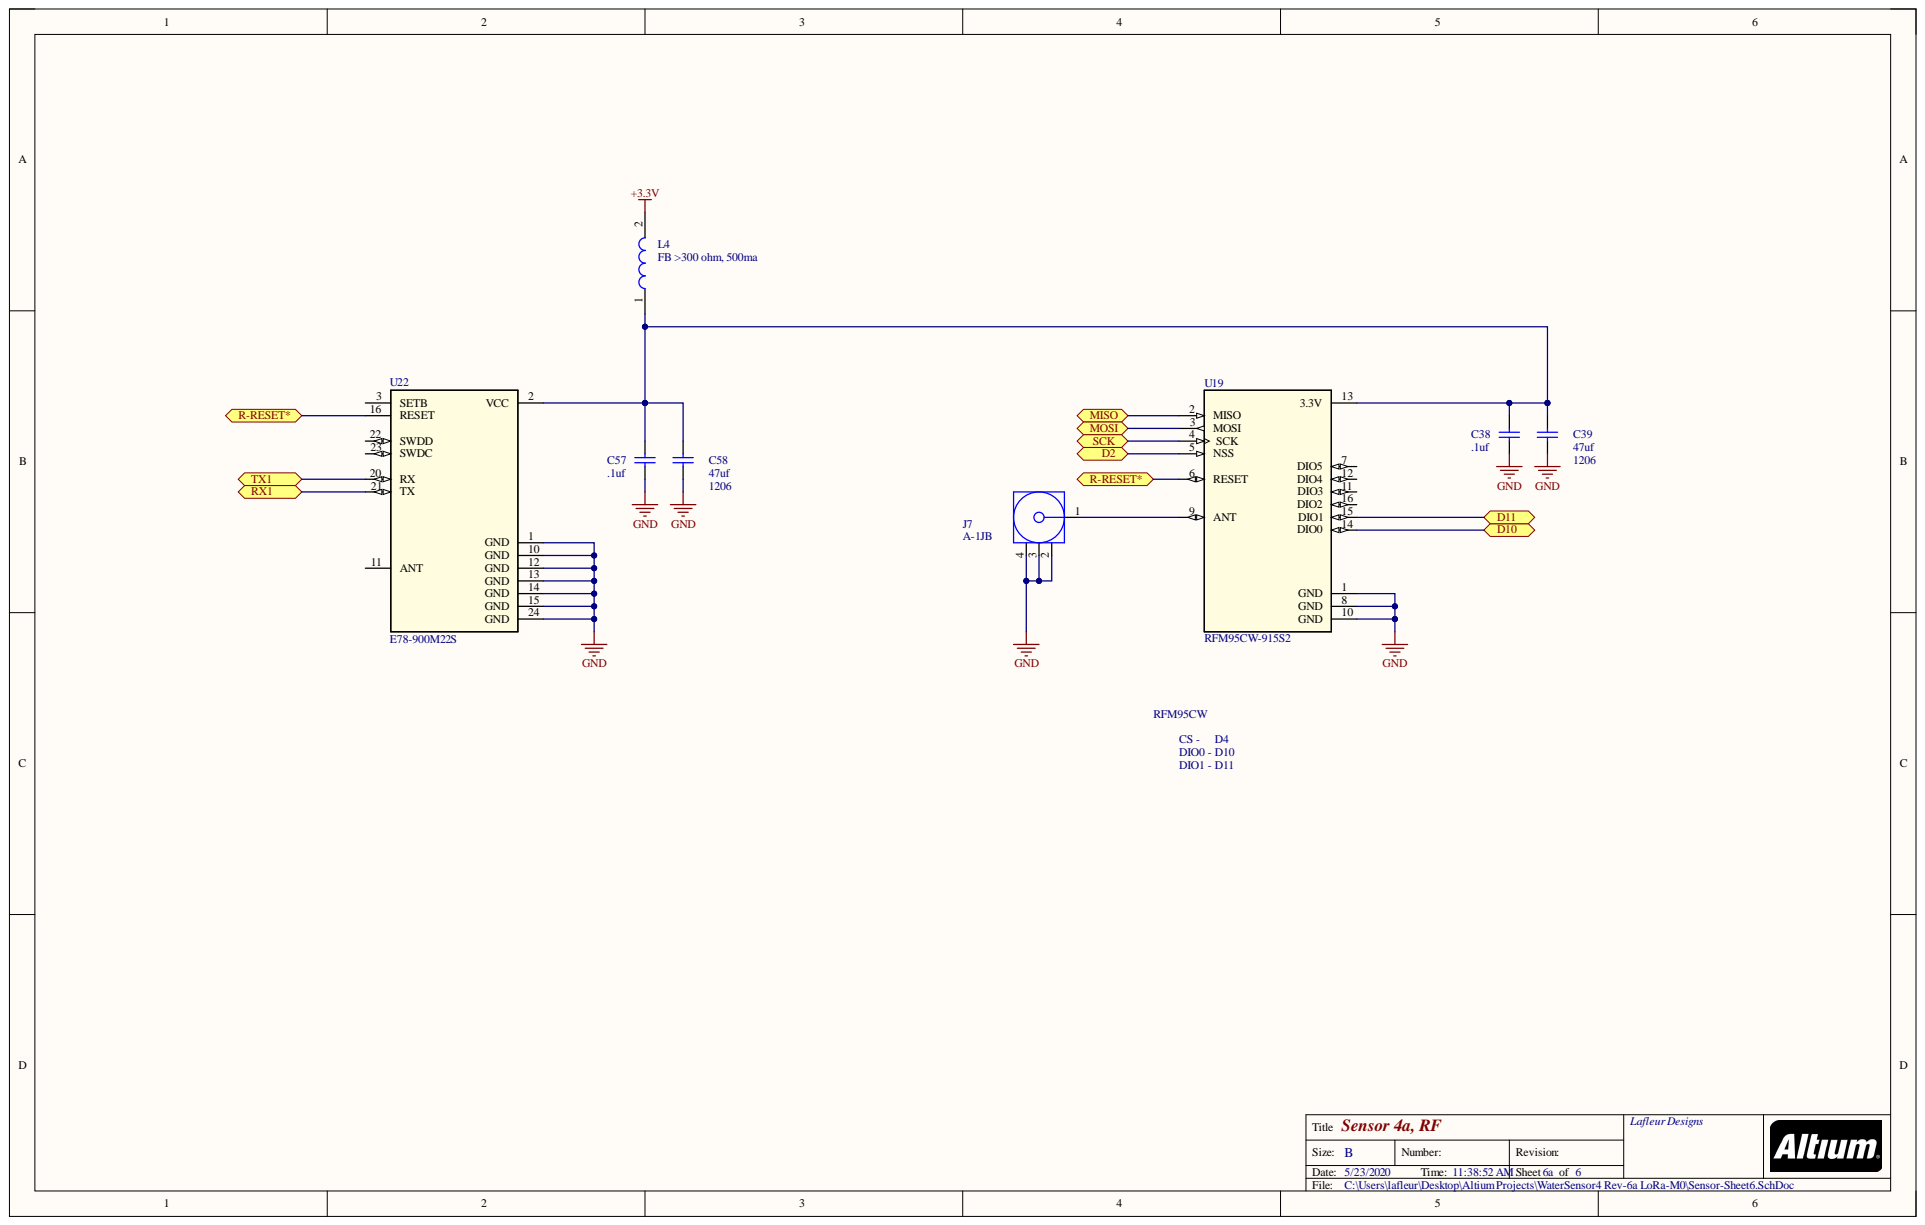
[picture p11: page 1]

U19 RFM95C NSS R ESE T A N T G N D G N D G N

Ti tl e Sensor 4a, R F | Lafleur Des igns

Si z e : B | N umber : | Revi s i on:
Dat e : 5/23/ 20 20 Ti me: 11:38:52 AM | | Sheet 6 a of 6

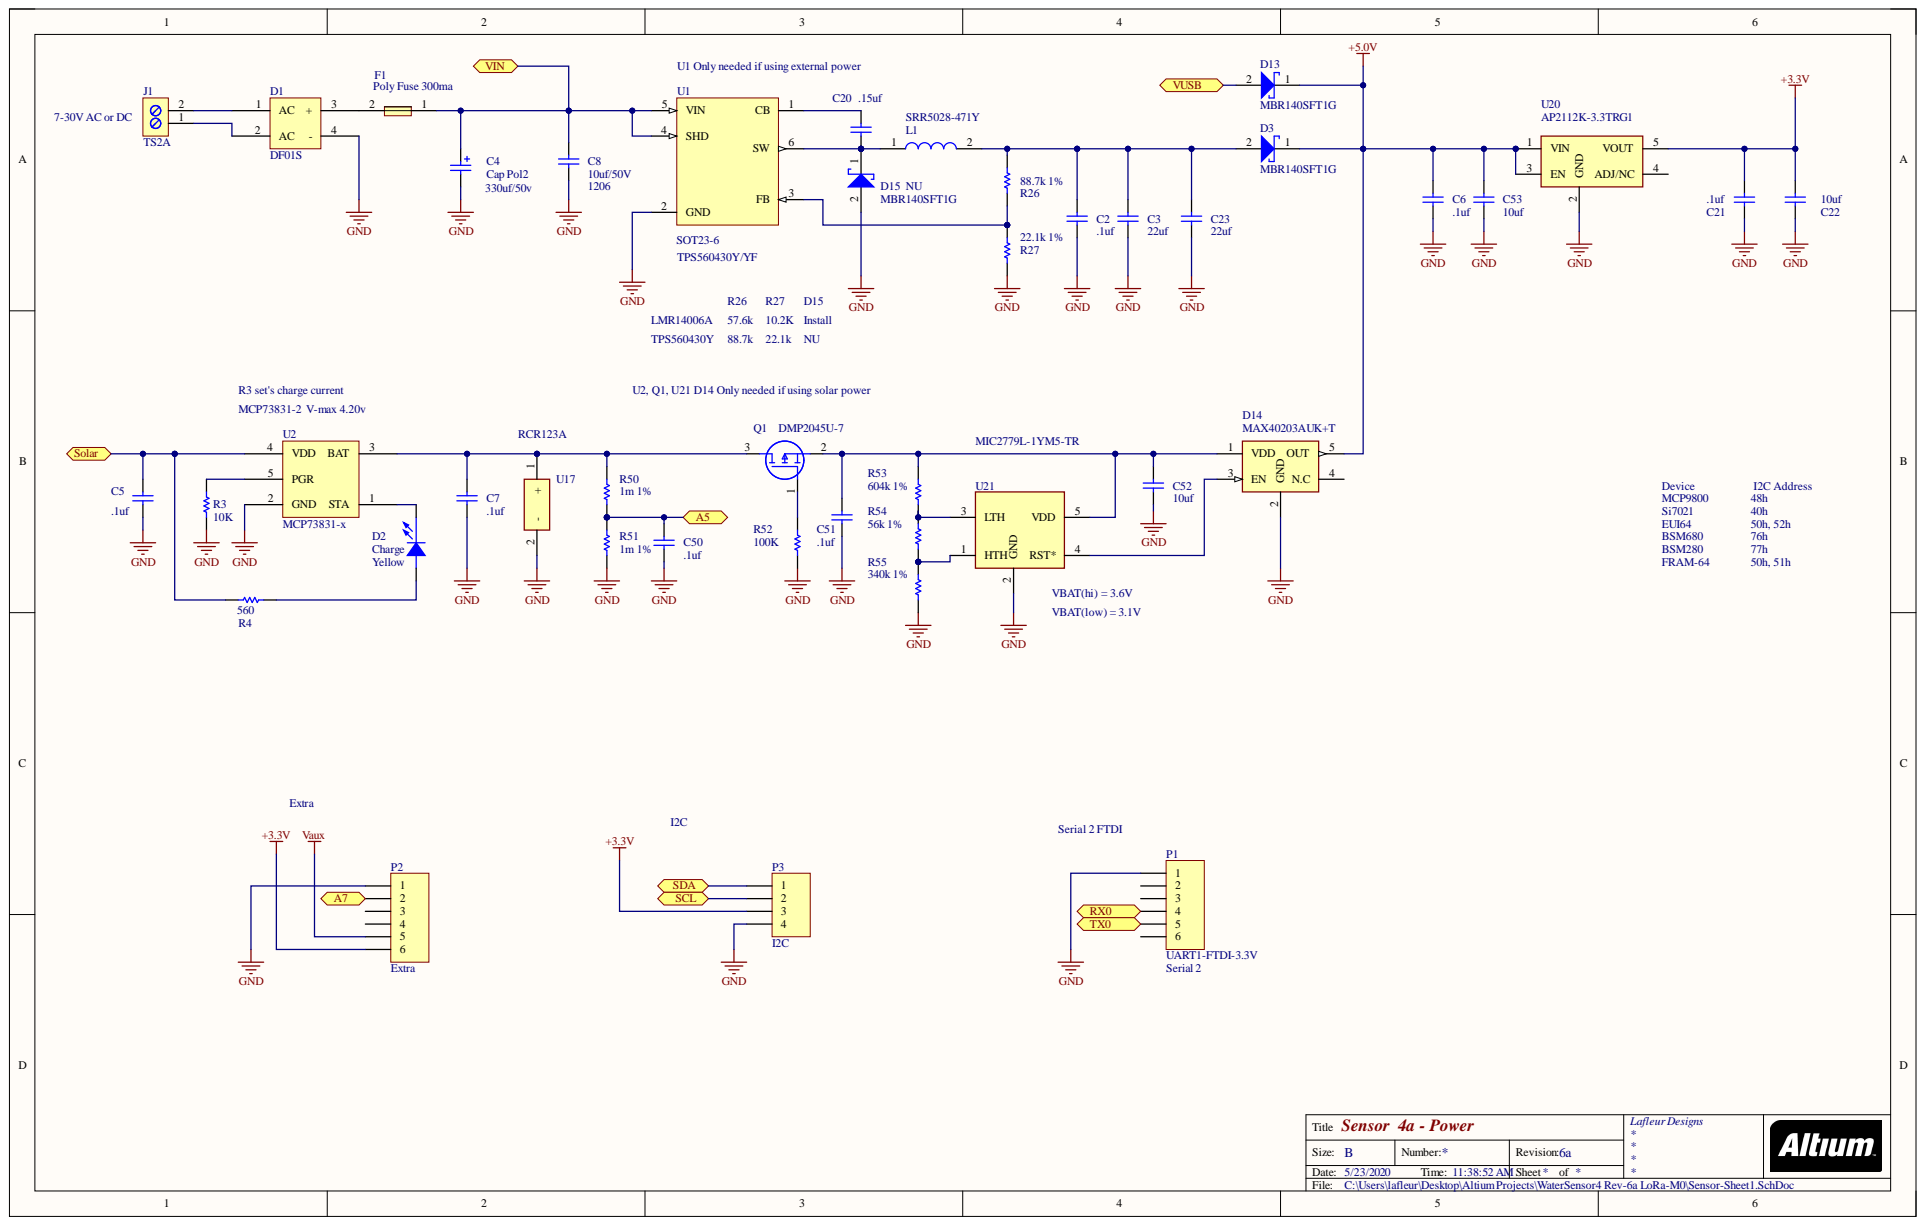
[picture p12: page 2]

U1 Only needed if using external power

U2, Q1, U21 D14 Only needed if using solar power

Title Sensor 4a - Power | Lafleur Designs * * * *

Size: B | Number: * | Revision: 6a
Date: 5/23/2020 Time: 11:38:52 AM | | Sheet * of *

C:\Users\lafleur\Desktop\AltiumProjects\WaterSensor4 Rev-6a LoRa-M0\Sensor-Sheet1.SchDoc

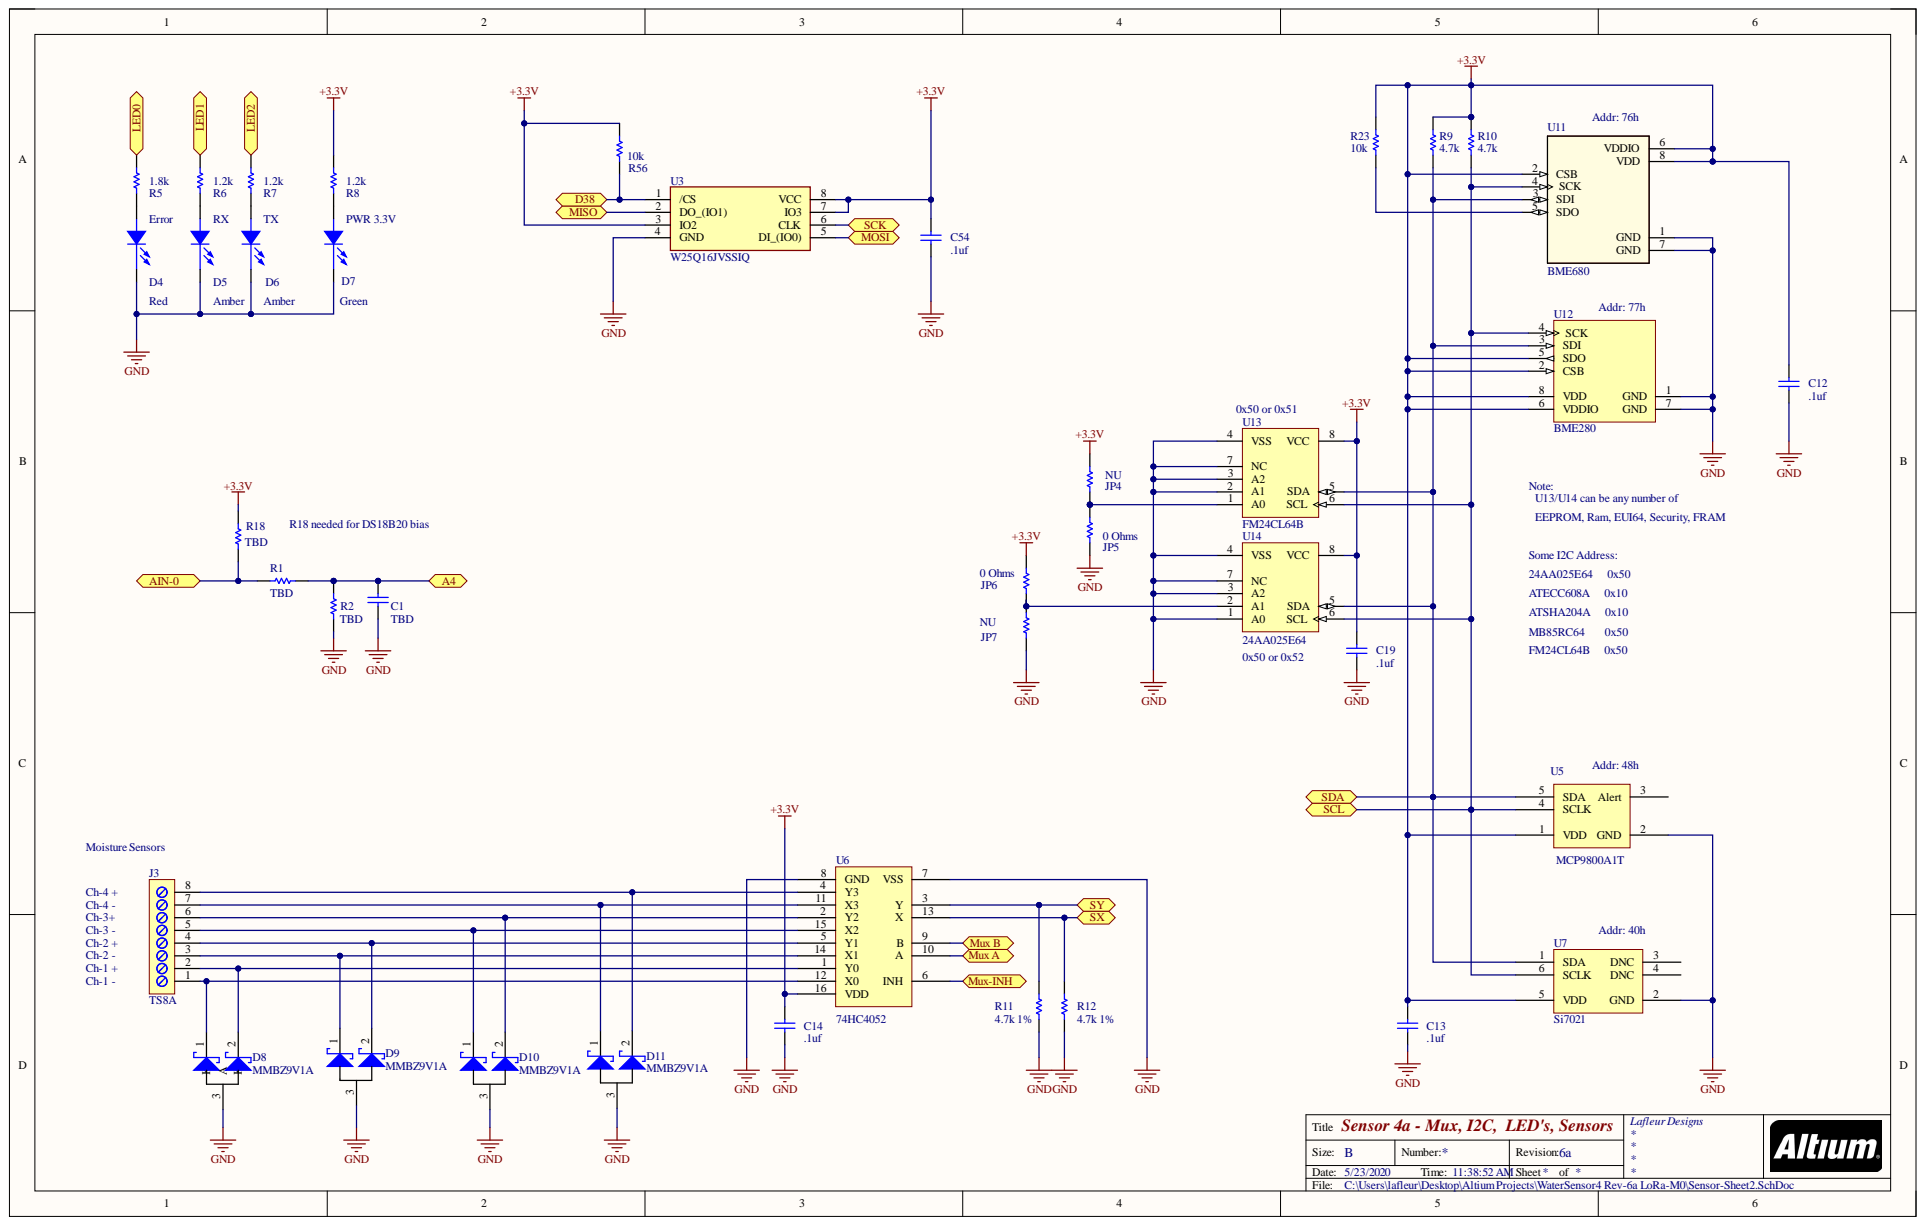
[picture p13: page 3]

+3.3V | SDI 3 SCK 4

SDO 5
CSB 2

Note:

U13/U14 can be any number of
EEPROM, Ram, EUI64, Security, FRAM

SCLK 4

Title Sensor 4a - Mux, I2C, LED's, Sensors | Lafleur Designs * * * *

Size: B | Number: * | Revision: 6a
Date: 5/23/2020 Time: 11:38:52 AM | | Sheet * of *

C:\Users\lafleur\Desktop\AltiumProjects\WaterSensor4 Rev-6a LoRa-M0\Sensor-Sheet2.SchDoc

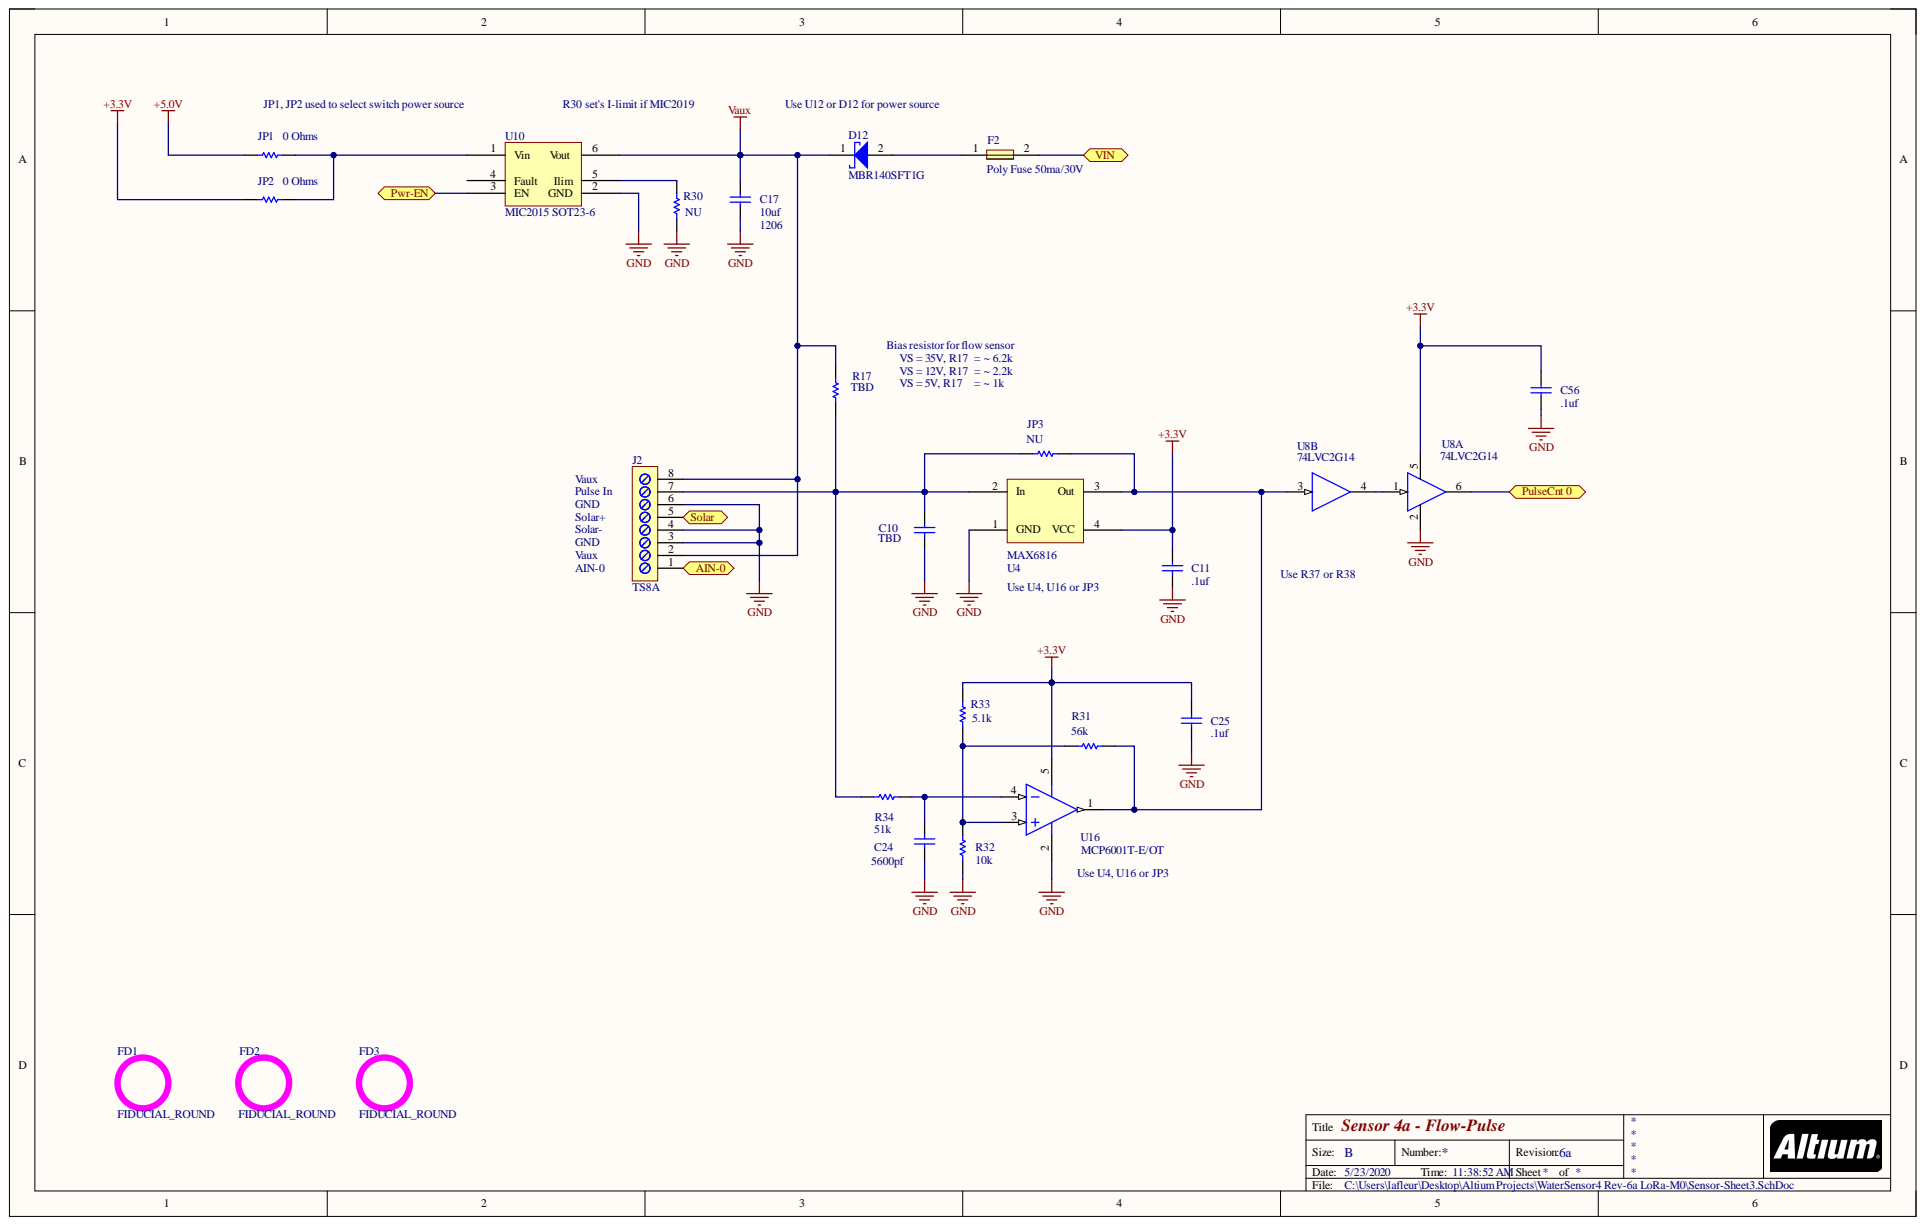
[picture p14: page 4]

Use U12 or D12 for power source

6 | | GND 1 | C11 C25
5 | Solar

Title Sensor 4a - Flow-Pulse | * * * * *

Size: B | Number: * | Revision: 6a
Date: 5/23/2020 Time: 11:38:52 AM | | Sheet * of *

C:\Users\lafleur\Desktop\AltiumProjects\WaterSensor4 Rev-6a LoRa-M0\Sensor-Sheet3.SchDoc

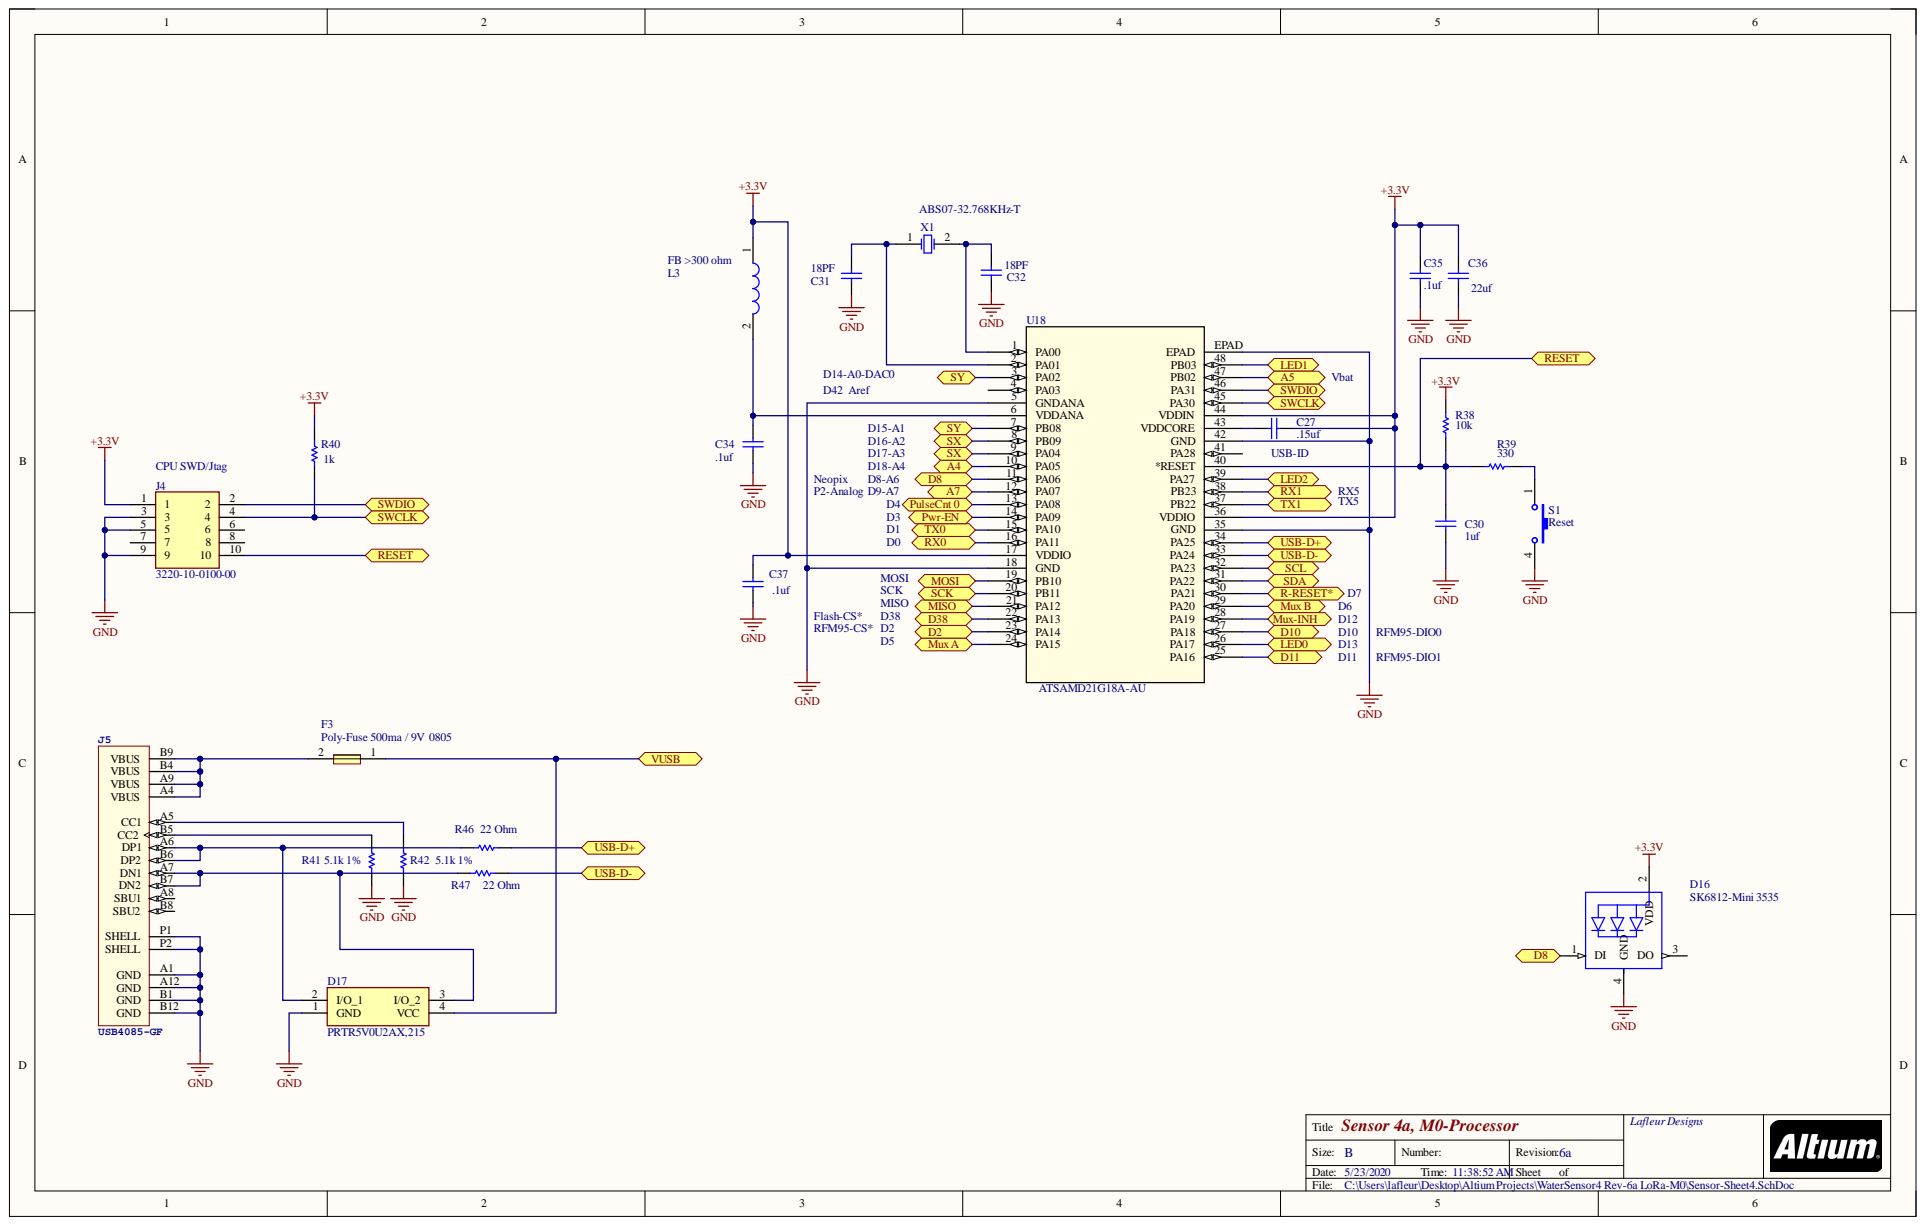
[picture p15: page 5]

B 4 | R46 22 O hm R47 22 O hm
A 9
A 4

B 5
A 6
B 6 | R41 5.1k 1% R42 5.1k 1%

A 1 | D17
A12

Ti tl e | Lafleur Des

Si z e : B | N umber : | Revi s i on:
Dat e : 5/23/ 20 20 Ti me: 11:38:52 AM | | Sheet of

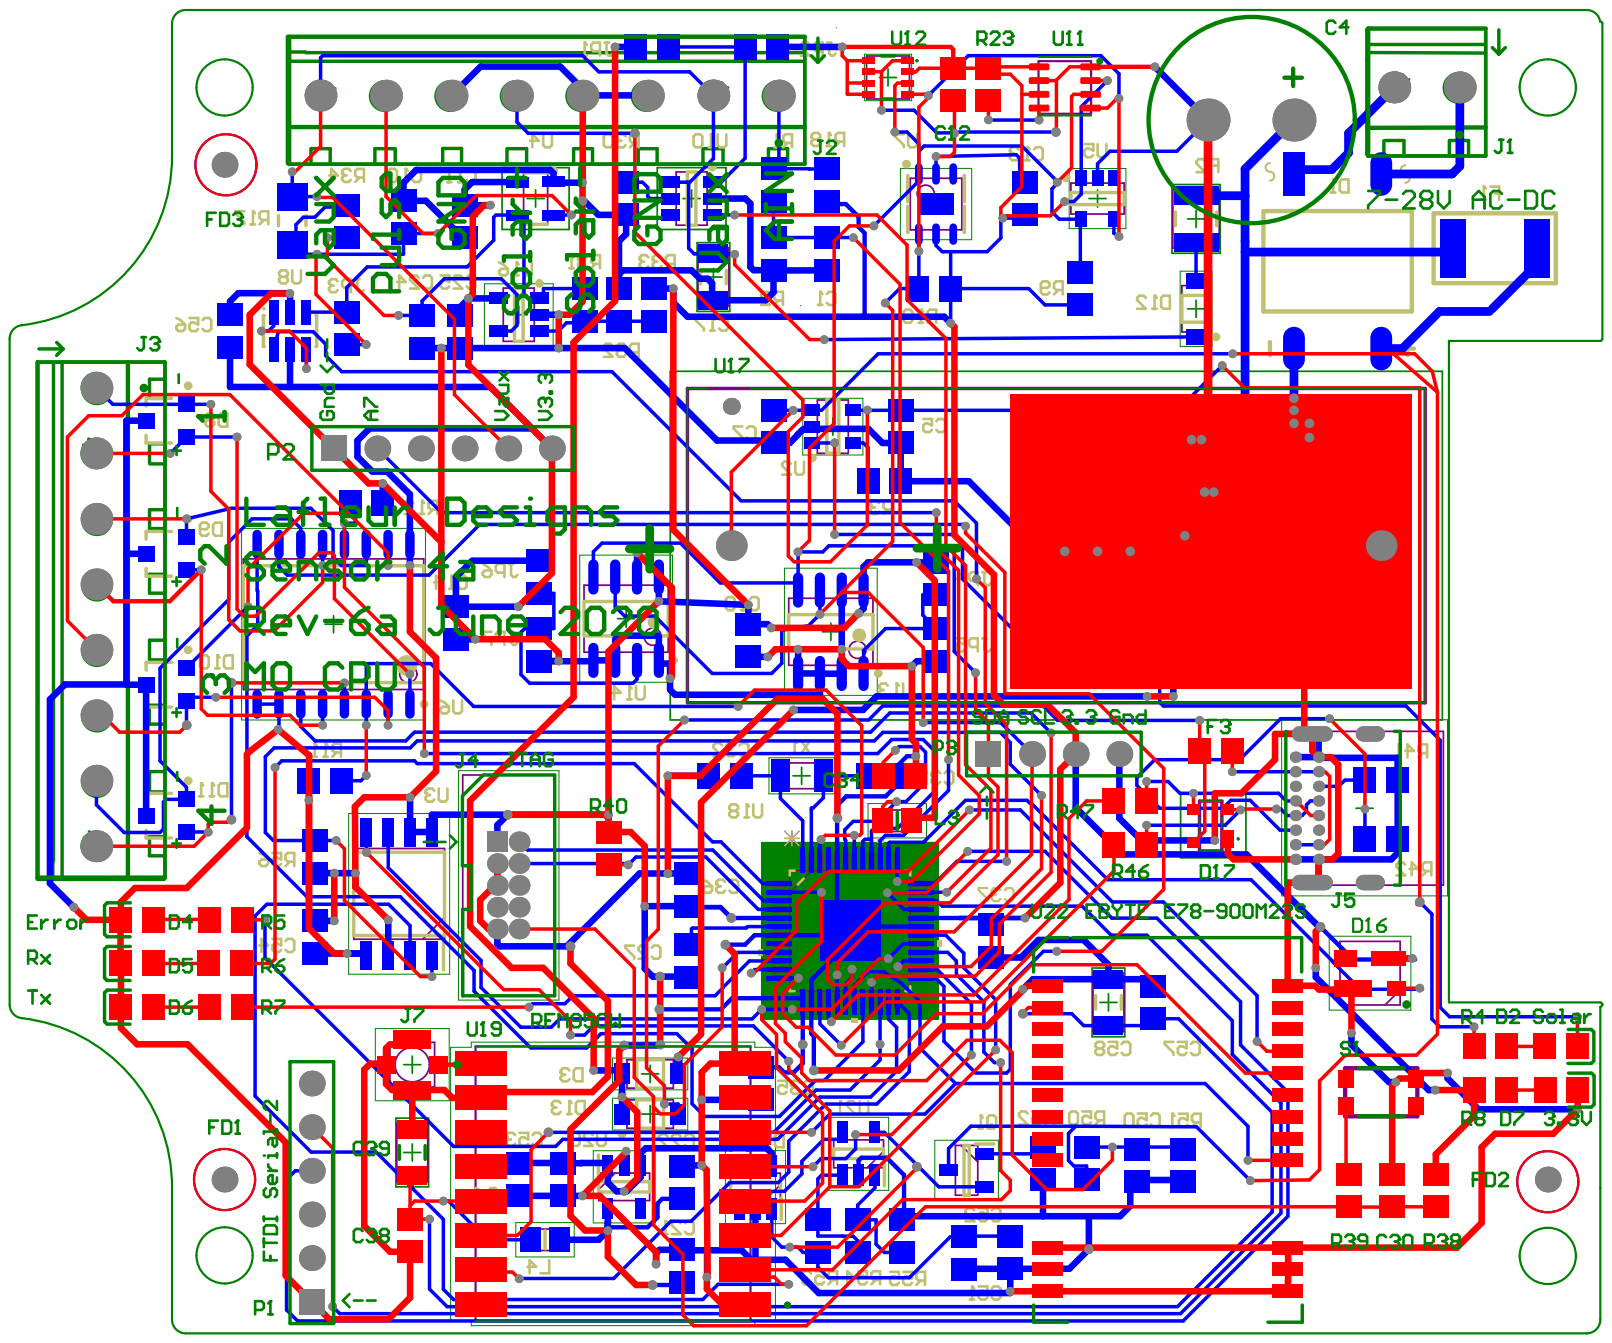
[picture p16: page 6]
