trlafleur/Sensor-3/(commit log)

2019-10-25 New files
    [WaterSensor V3-5b.xls]
2020-05-23 Updated sensor 3 and 4 doc
